Flynsky/VHF_Transceiver/doc/latex/overview.tex

\input{setup.tex}
% install libaries with: sudo dnf install texlive-scheme-medium
% compile with: pdflatex -shell-escape dsp_cheatsheet.tex

\begin{document}
\begin{center}
	{\vspace{-4cm}
		\LARGE \textbf{VHF Tranceiver for CUBSAT Applications}}\\
	\small Fynn Gewiese | \href{https://github.com/Flynsky}{github}\\
	\rule{\linewidth}{0.3pt}
\end{center}

% \begin{multicols*}{2}
\raggedcolumns{\small\tableofcontents}

\section{Requirements}

\begin{minipage}{0.45\textwidth}
	\begin{itemize}
		\item Frequency Band: 134--174\,MHz (VHF)
		\item Data Rate: > 1k bps
		\item Tx Power: 0.3\,W / -5.2 dBW / 25.8 dBm
		\item Antenna Gain Satellite: >= 2.2 dBi
		\item Sattellite Effective Isotropic Radiated Power: -5.3 dBW
		\item Rx Sensitivity:
		\item TCXO Temperature Compensated Crystal Oscillator
	\end{itemize}
\end{minipage}
\hfill
\begin{minipage}{0.5\textwidth}
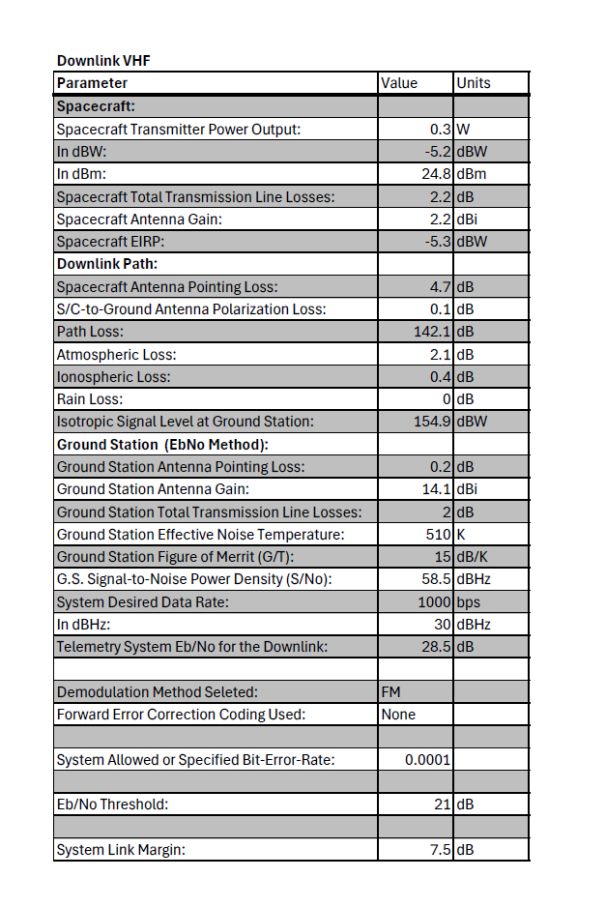
[picture p1: doc/latex/assets/RequireGroundstation.png]
	
	{Random Requirements from Christian}
\end{minipage}

\newpage
Friis Power Estimate:
\begin{figure}[H]
	\centering
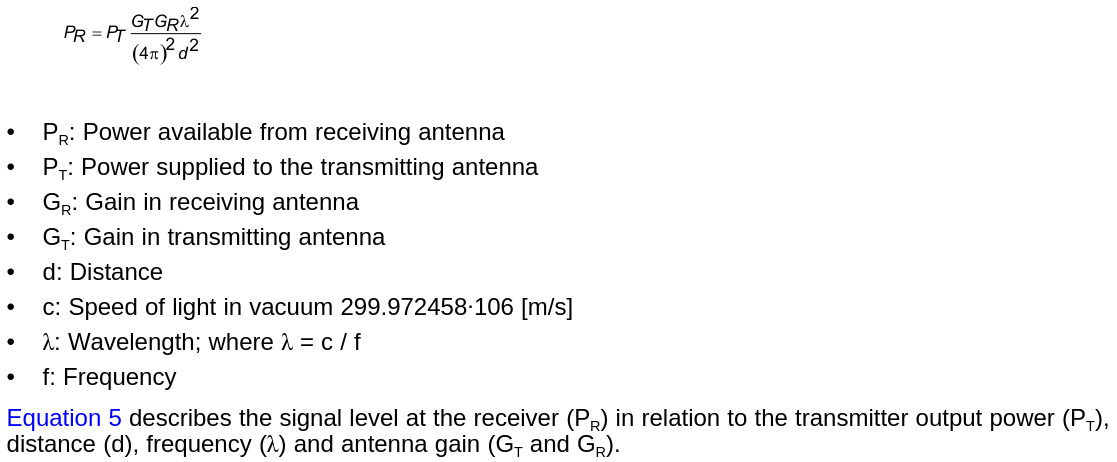
[picture p2: doc/latex/assets/Friis.png]
	
	\caption{}
	\label{fig:friis}
\end{figure}

\newpage
\section{Transceiver}

\subsection{Selection}
Ain't noboady designing a rf frontend from scratch,
an integrated seolution is the way to go.
Modules would be certified and less work,
but don't offer best flexibility and are boring af (for real).

Chips would require design and measurement of the antenna matching circuit,
but also could possibly compensate an antenna missmatch
and are only power limited by how much of an power amplifier you add.
\begin{itemize}
	\item CC1121/5 digital and well documented. Goat
	\item STM32 chips: SPIRIT1QTR, S2-LP, STM32WLE4/5xx well documented, STM in HF is iffy though
	\item ADF7020-1BCPZ-RL7 cheap Analog Devices. surley good (AD always cooking), but not very popular
	\item SA818-U looks like trash because it is. Analog FM. Very popular
	\item SX1261/2 150 MHz - 960 MHz Who tf is Semtech? Good on paper though
	\item Si446x (119–1050 MHz), looks perfect, reddit says: "\href{https://www.reddit.com/r/amateurradio/comments/qtlhz3/rf_tranceiver_ics_any_that_cover_2m_125m_70cm_and/}{most incredibly dense collection of bugs of any part I've ever worked with}".
	\item AX5043 Good things on the internet. N.A and Dead but apperently good
\end{itemize}

\subsection{CC1121/5}
Pin compatible Chips, CC1125 has a more narrow band than CC1121 so is to be preferred.
Can be paired with a power amplifier like Gali 74+ to get +38 dBm :) \href{https://www.youtube.com/watch?v=9ZoO_AABzqU&t=313s}{youtube link}

% \begin{figure}[H]
% 	\begin{minipage}{0.28\textwidth}
% 		\centering
% 		\includegraphics[width=\textwidth]{assets/CC1125.png}
% 		\caption{cc1125}
% 	\end{minipage}
% 	\begin{minipage}{0.28\textwidth}
% 		\centering
% 		\includegraphics[width=\textwidth]{assets/Gali74.png}
% 		\caption{Gali74 +}
% 	\end{minipage}
% \end{figure}

\begin{figure}[H]
	\begin{minipage}{0.20\textwidth}
		\centering
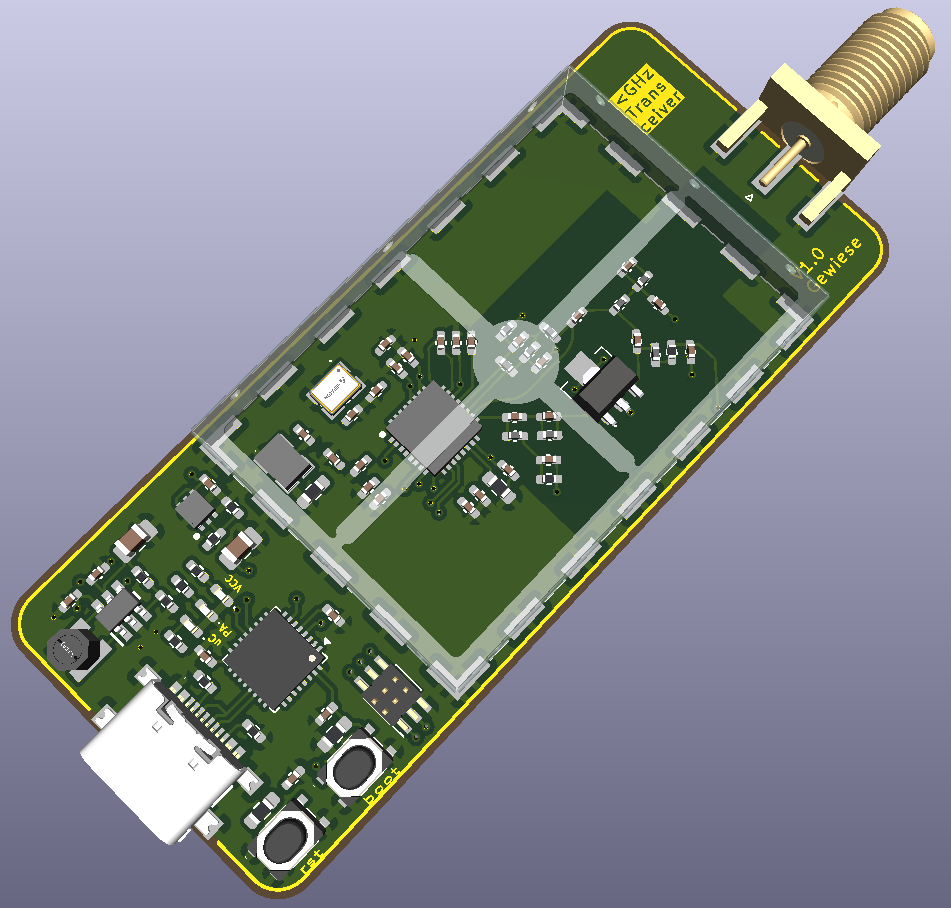
[picture p3: doc/latex/assets/3Drender.png]
		
		\caption{3D render}
	\end{minipage}
	\begin{minipage}{0.70\textwidth}
		\centering
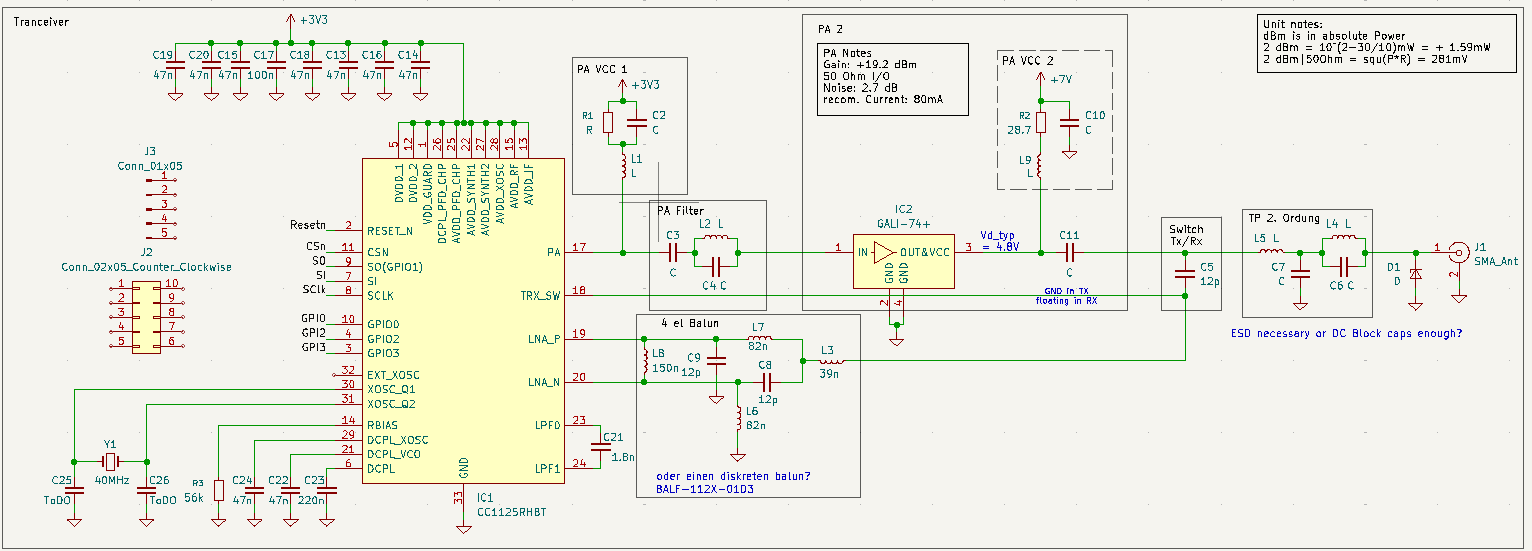
[picture p4: doc/latex/assets/schematic.png]
		
		\caption{schematic}
	\end{minipage}
\end{figure}

\begin{figure}[H]
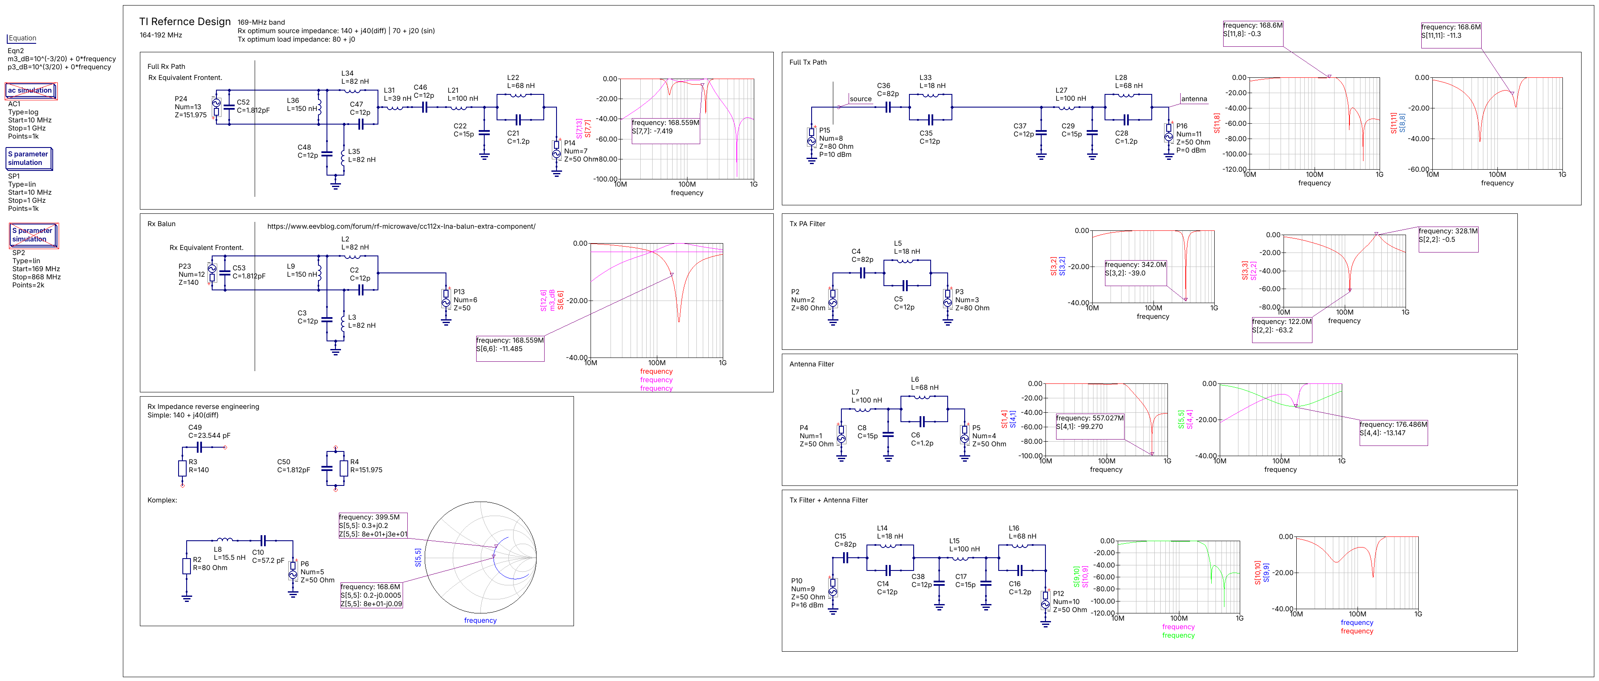
[picture p5: doc/latex/assets/simul.png]
	
\end{figure}
% \begin{figure}[h]
%   \centering
%   \includegraphics[width=0.8\textwidth]{assets/oi.png}
%   \caption{}
%   \label{fig:oi}
% \end{figure}

\subsection{SA818-U}
RDA1846 (8 dBm) chip + PA + microcontroller. \href{http://ptptelecom.com/openlmrorg/Tiny_Transcievers.html}{Disassembly}
\begin{figure}[H]
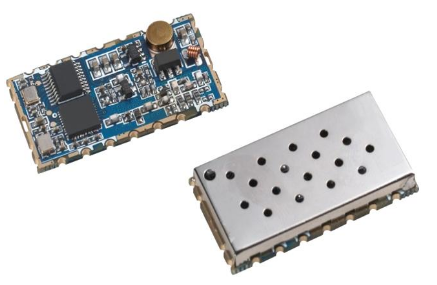
[picture p6: doc/latex/pics/SA818.png]
	
\end{figure}

\newpage
\section{Antenna}

\subsection{Mechanical considerations}
\paragraph{Requirements:}
\begin{itemize}
	\item Non ferro magnetic
	\item good impedance match
\end{itemize}

\paragraph{Antenna Types:}.

\begin{figure}[H]
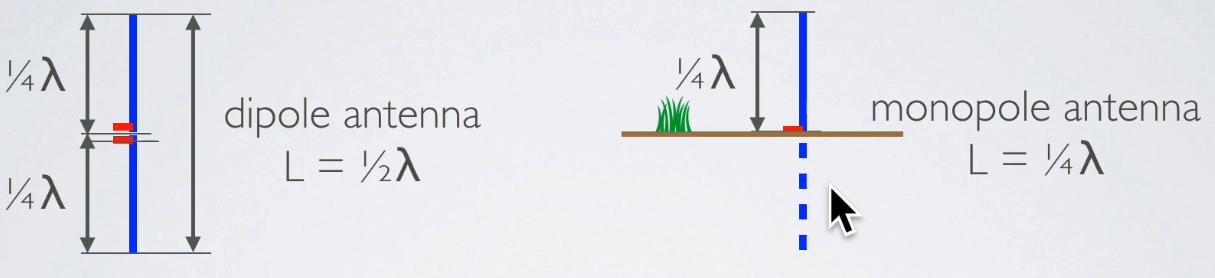
[picture p7: doc/latex/assets/monovsdipole.png]
	
	\caption{Mono vs Dipole}
\end{figure}
\href{https://www.youtube.com/watch?v=doDcpkyw-U8}{good video about antenna design}
\begin{table}[H]
	\centering
	\renewcommand{\arraystretch}{1.3}
	\begin{tabular}{llllll}
		\toprule
		\textbf{} & \textbf{Antenna Type}  & \textbf{Length} (150MHz) & \textbf{Impedance ($\Omega$)} & \textbf{Gain (dBi)} & \textbf{Notes}                         \\
		\midrule
		\multicolumn{6}{l}{\textit{Dipole Variants}}                                                                                                     \\
		\midrule
		\textcolor{red}{N}  & $3\lambda/2$ Dipole    & $1.5\lambda = 3.0\,$m    & $\approx 100$--$150$          & $3.8$               & Narrower pattern                       \\
		\textcolor{red}{N}  & Full-Wave Dipole       & $\lambda = 2.0\,$m       & $\approx 200$                 & $2.41$              & High impedance                         \\
		\textcolor{green}{Y} & Half-Wave Dipole       & $\lambda/2 = 1.0\,$m     & $\approx 73$                  & $2.15$              & Reference antenna                      \\
		\textcolor{yellow}{M}  & Folded Dipole          & $\lambda/2 = 1.0\,$m     & $\approx 288$                 & $2.15$              & Wider bandwidth                        \\
		\textcolor{yellow}{M} & Short Dipole           & $\ll \lambda/2$          & $\approx 20 + jX$             & $< 2.15$            & Needs matching, very small             \\
		\midrule
		\multicolumn{6}{l}{\textit{Monopole Variants (over ground plane)}}                                                                               \\
		\midrule
		\textcolor{red}{N}  & Half-Wave Monopole     & $\lambda/2 = 1.0\,$m     & $\approx 100$--$150$          & $5.2$               & High impedance                         \\
		\textcolor{green}{Y}  & Quarter-Wave Monopole  & $\lambda/4 = 0.5\,$m     & $\approx 36.5$                & $5.15$              & Most common, easy to match             \\
		\textcolor{green}{Y}  & Five-Eighths Monopole  & $5\lambda/8 = 1.25\,$m   & $\approx 50$                  & $6.0$               & Self-matching, popular \href{https://www.pmr-funkgeraete.de/Funkgeraete/Amateurfunk/Zubehoer-AFU/Mobilantennen-AFU-KW-VHF-UHF/Diamond-MC-101-PL-Antennenstrahler-134-174-MHz::11365.html}{commercial example}                \\
		\textcolor{yellow}{M}  & Three-Eighths Monopole & $3\lambda/8 = 0.75\,$m   & $\approx 150 + j150$          & $5.5$               & Needs matching                         \\
		\textcolor{red}{N}  & Short Monopole         & $\ll \lambda/4$          & $\approx 10 + jX$             & $< 5.15$            & Needs matching                         \\
		\midrule
		\multicolumn{6}{l}{\textit{CubeSat-Relevant Antennas at 150\,MHz ($\lambda \approx 2.0\,$m)}}                                                    \\
		\midrule
		\textcolor{yellow}{Y}  & Turnstile              & $2\times\lambda/2$       & $\approx 50$                  & $2.15$              & Circular polarization, low profile     \\
		\textcolor{yellow}{Y}  & Crossed Dipole         & $2\times\lambda/2$       & $\approx 73$                  & $2.15$              & Circular pol., needs 90° hybrid        \\
		\textcolor{green}{Y}  & Tape Measure Dipole    & $\lambda/2 = 1.0\,$m     & $\approx 73$                  & $2.15$              & Deployable, flight-proven              \\
		\textcolor{green}{Y}  & \href{https://www.youtube.com/watch?v=bElqBRvqTdo}{Stacer Monopole}       & $\lambda/4 = 0.5\,$m     & $\approx 36.5$                & $5.15$              & Deployable coil spring, common CubeSat \\
		\textcolor{yellow}{M}  & Patch (on body)        & $\lambda/2$ aperture     & $\approx 100$--$300$          & $6.0$--$8.0$        & Low profile, but large at 150\,MHz     \\
		\textcolor{yellow}{M}  & Helical (axial mode)   & $n \cdot \lambda$        & $\approx 100$--$150$          & $10$--$15$          & Circular pol., high gain, directional  \\
		\bottomrule
	\end{tabular}
	\caption{Dipole, monopole, and CubeSat antenna options at $150\,\text{MHz}$ ($\lambda \approx 2.0\,\text{m}$, $\lambda/2 \approx 1.0\,\text{m}$, $\lambda/4 \approx 0.5\,\text{m}$)}
	\label{tab:antenna_150MHz}
\end{table}
So dipole is huge,
but monopole is also problematic.
It needs a ground plane, which can be solid or wires or a mesh.
If the groundplane radius is higher than $1/2 \lambda$ it's aproximately infinite 
and performance is optimal.
Groundplain changes gain and impedance.

\begin{figure}[H]
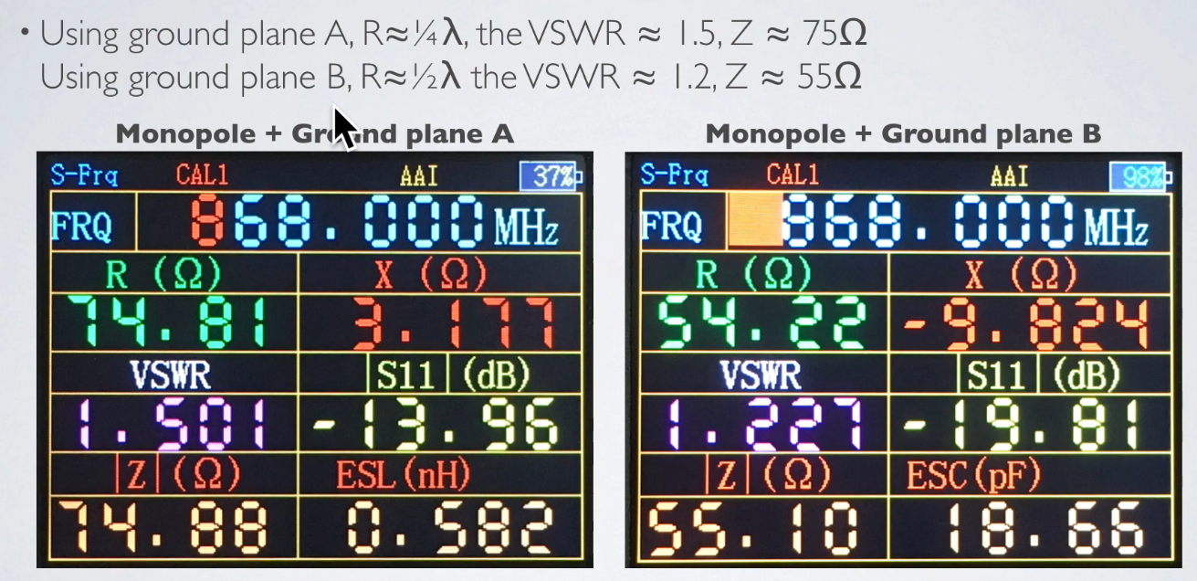
[picture p8: doc/latex/assets/ground plane effect out of a randoms youtubers video.png]
  
  \caption{ground plane effect out of a randoms youtubers video}
\end{figure}

The sides of the cubesat are an start, but 10x10cm are way smaller than the required $1/2 \lambda$.\\
Maybe the solar panels could function as ground plane?

\paragraph{Ti Research of 196 MHz Antennas}.

\begin{figure}[H]
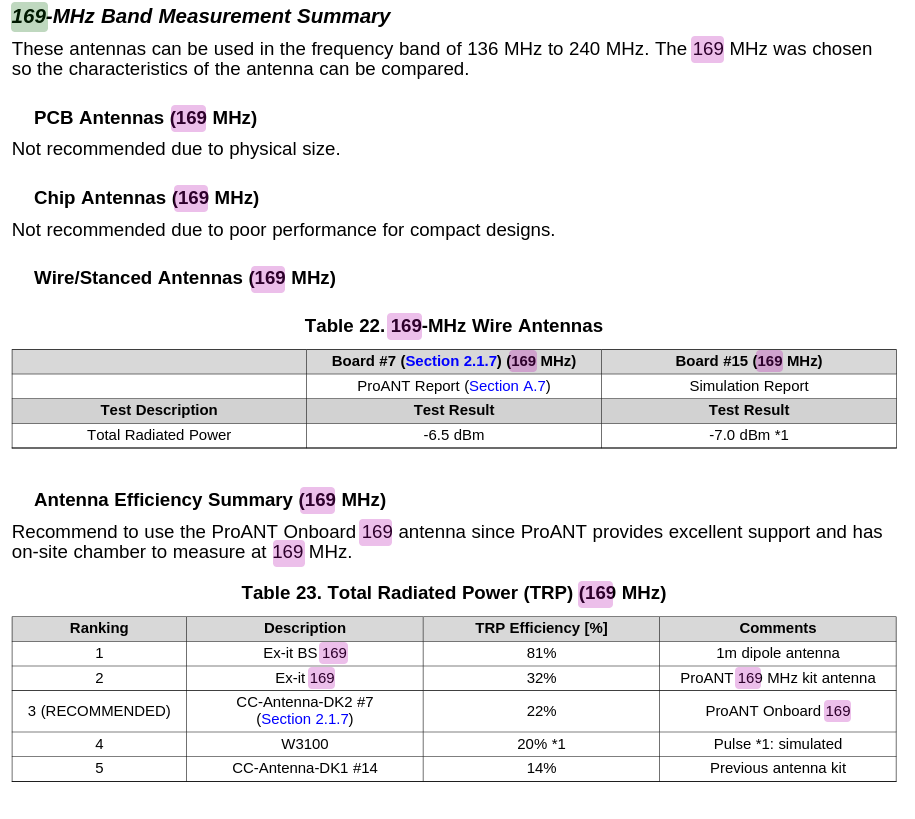
[picture p9: doc/latex/assets/TiAntennaComparison.png]
	
	\caption{Ti application note swra496a page 45 antenna comparison}
	\label{fig:tiantennacomparison}
\end{figure}

\paragraph{Spring based system:}.

\begin{figure}[H]
	\begin{minipage}{0.38\textwidth}
		\centering
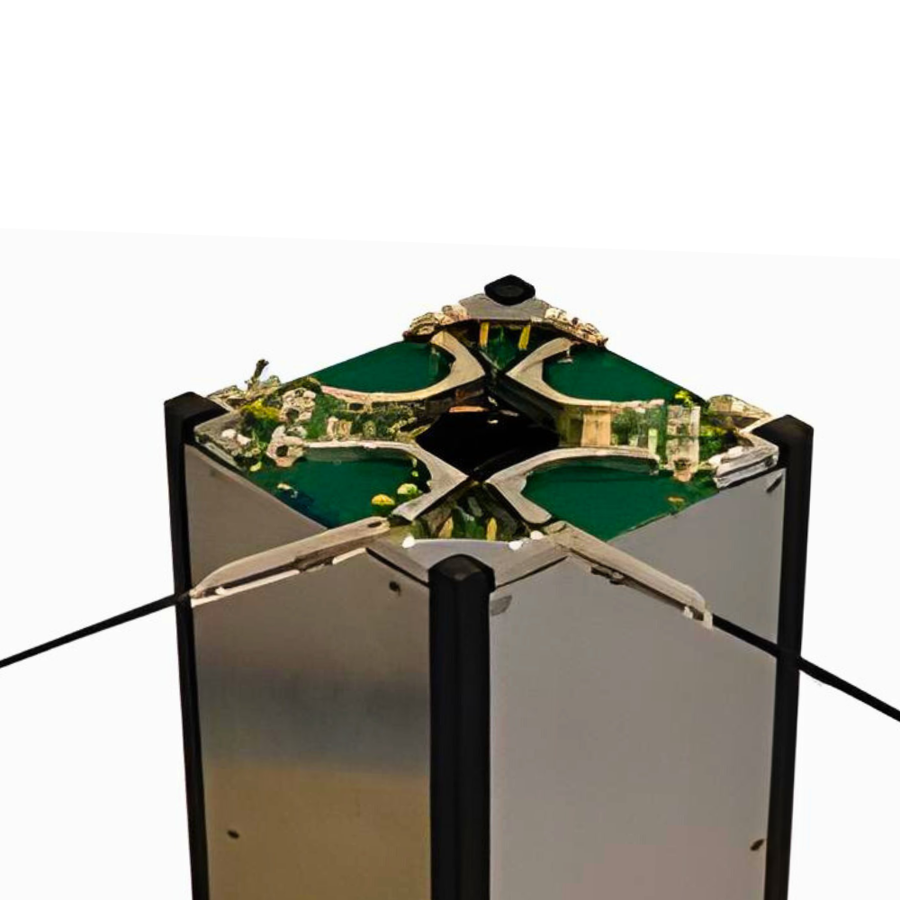
[picture p10: doc/latex/assets/commertialSolution.png]
		
		\caption{Commertial solution \href{https://www.isispace.nl/product/vhf-uhf-antenna-for-1u-3u/}{ISISPACE VHF/UHF antenna}}
		\label{fig:commertialsolution}
	\end{minipage}
	\begin{minipage}{0.38\textwidth}
		\centering
		
	\end{minipage}
\end{figure}

\paragraph{Roll based system:}.
\begin{figure}[H]
	\begin{minipage}{0.38\textwidth}
		\centering
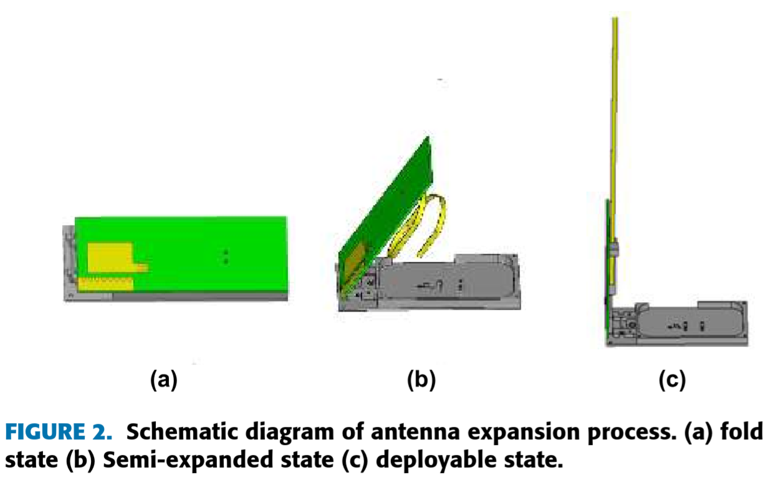
[picture p12: doc/latex/pics/fold.png]
		
		\caption{\href{https://www.researchgate.net/publication/342999505_Compact_UHFVHF_Monopole_Antennas_for_CubeSats_Applications}{paper}}
		% \label{fig:cc1125}
	\end{minipage}
	\begin{minipage}{0.38\textwidth}
		\centering
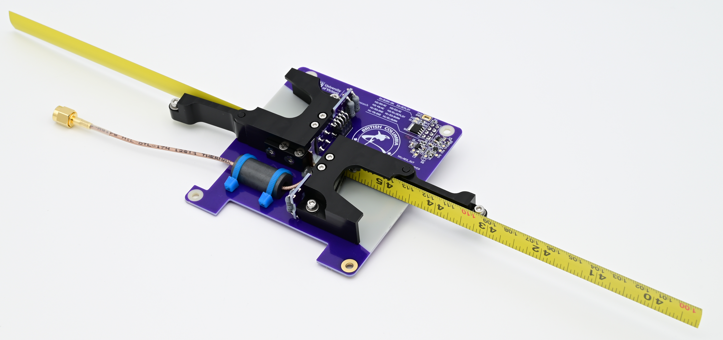
[picture p13: doc/latex/pics/spring.jpg]
		
		\caption{\href{https://gitlab.orcasat.ca/orcasat-group/orcasat-antenna}{OrcaSat}}
		\label{fig:gali74}
	\end{minipage}
\end{figure}

\paragraph{SMD Antenna:}.

\begin{figure}[H]
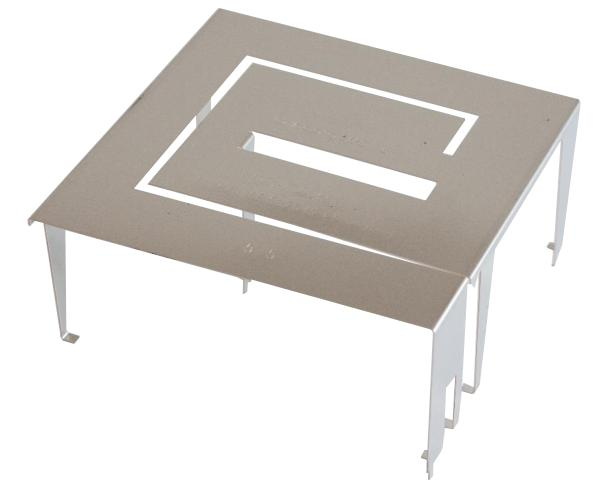
[picture p14: doc/latex/assets/smdantenna.png]
	
	\caption{\href{https://satronel.com/products/antennas/embedded/proant-pifa-antennas/onboard-smd-169-mhz-pro-ob-508.html}{OnBoard PRO-OB-508}}
\end{figure}

\subsection{Material Choice}
The non ferromagnetic requirement will need an exotic metal
and probably a treatment like hardening or cold rolling.
\begin{itemize}
	\item strip steel. Used in tape measures. ferromagnetic but serves as comparison.
	\item Beryllium copper (C17200). Very sex(according to google AI). no way that this springs. on amazon. \href{https://www.youtube.com/shorts/Kf07CvRD3Ck}{youtube link}
	\item 13RM19. strip steel but special non ferromagnetic. hard to obtain, ask for offcuts?
	\item 1.4310. shitty brother of 13RM19
\end{itemize}

\begin{tabular}{lcccc}
	\toprule
	\textbf{material} & magnetization & Dehngrenze $R_{p0{,}2\%}$ & elastisity  & specific R \\
	                  &               & $N/mm ^ 2$                & $kN/mm ^ 2$              \\
	\midrule
	1.4310            & low           & 210                       & 200                      \\
	                  &               &                           &                          \\
	                  &               &                           &                          \\
	\bottomrule
\end{tabular}

\begin{figure}[h]
  \centering
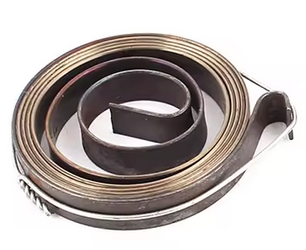
[picture p15: doc/latex/assets/copper_measer.png]
  
  \caption{\href{https://www.alibaba.com/product-detail/HengSheng-Beryllium-Copper-Flat-Tape-Measure_1600205576417.html}{rewind spring for leaf blower Beryllium Copper Flat Tape}}
  \label{fig:copper_measer}
\end{figure}
\subsection{Simulation}
free to use software:
\begin{itemize}
	\item 4nec2
	\item MMANA-GAL
\end{itemize}

\subsection{Testing}

\subsection{Relevant papers:}
\begin{itemize}
	\item \href{}{Compact UHF/VHF Monopole Antennas for CubeSats Applications}
\end{itemize}

% \end{multicols*}
\end{document}
