Flynsky/VHF_Transceiver/doc/latex/overview.pdf

## VHF Tranceiver for CUBSAT Applications

Fynn Gewiese | github (https://github.com/Flynsky)

## Inhaltsverzeichnis

1 Requirements | 1
2 Transceiver | 3
3 Antenna | 4

## 1 Requirements

- Frequency Band: 134–174 MHz (VHF)
- Data Rate: > 1k bps
- Tx Power: 0.3W / -5.2 dBW / 25.8 dBm
- Antenna Gain Satellite: >= 2.2 dBi
- Sattellite Effective Isotropic Radiated Power: -5.3 dBW
- Rx Sensitivity:
- TCXO Temperature Compensated Crystal Oscillator

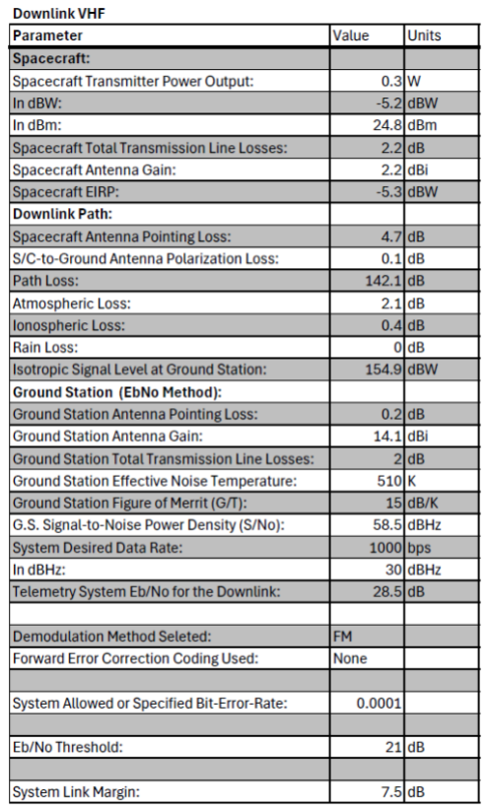
[picture p16: figure]

Random Requirements from Christian

Friis Power Estimate:


Abbildung 1

## 2 Transceiver

### 2.1 Selection

There are not many transcievers chips avaliable. Chips would require design and measurement of the antenna matching circuit, but also could possibly compensate an antenna missmatch.

- CC1121/5 digital and well documented. Requires PA like SMA70-2
- ADF7020-1BCPZ-RL7 cheap Analog Devices.
- SA818-U looks like trash because it is. Analog FM
- SX1261/2 150 MHz - 960 MHz
- Si446x (119–1050 MHz), looks perfect, reddit says is a bit buggy.
- AX5043 Good things on the internet. N.A and Dead but apperently good

### 2.2 CC1121/5

Pin compatible Chips, CC1125 has a more narrow band than CC1121 so is to be preferred. Can be paired with a power amplifier like Gali 74+ to get +38 dBm :) youtube link (https://www.youtube.com/watch?v=9ZoO_AABzqU&t=313s)

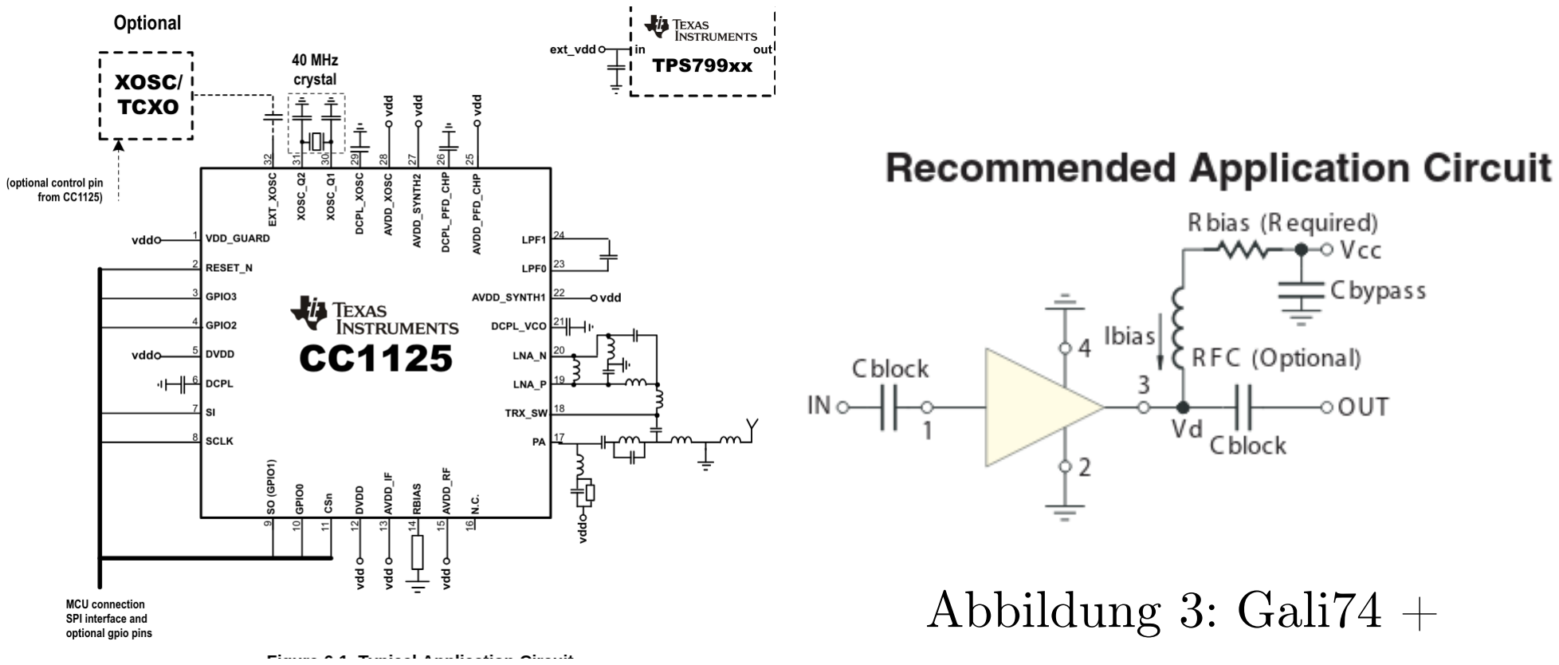
[picture p17: figure]
Abbildung 3: Gali74 +

Abbildung 2: cc1125

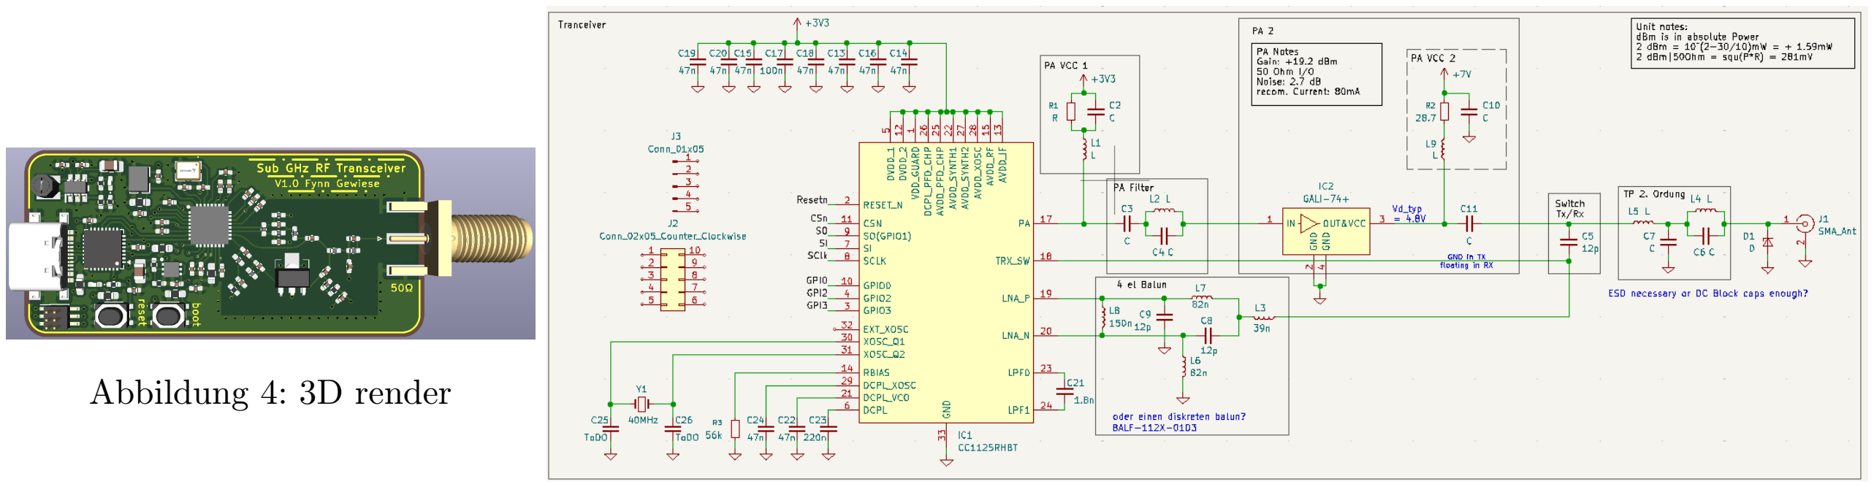
[picture p18: figure]
Abbildung 4: 3D render

Abbildung 5: schematic


### 2.3 SA818-U

RDA1846 (8 dBm) chip + PA + microcontroller. Disassembly (http://ptptelecom.com/openlmrorg/Tiny_Transcievers.html)

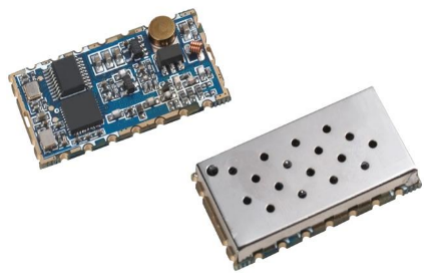
[picture p19: figure]

### 2.4 Si446x

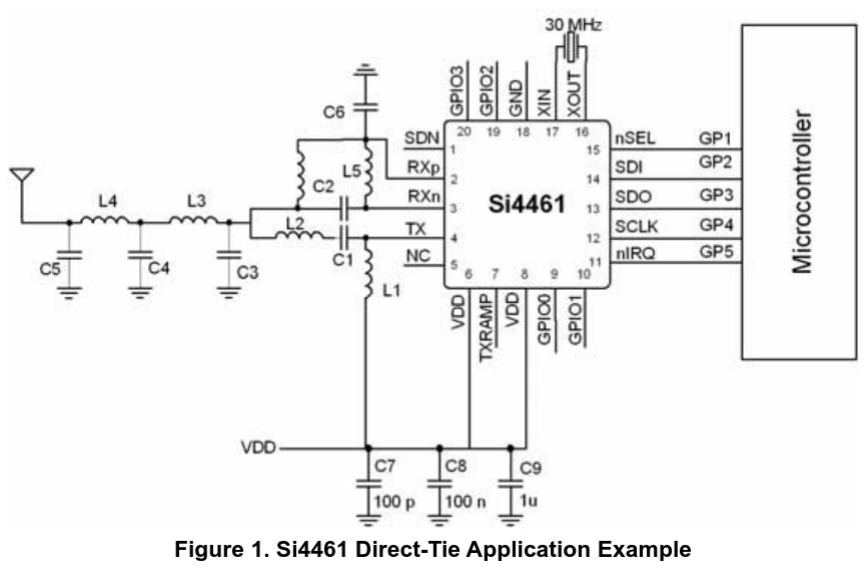
[picture p20: figure]

## 3 Antenna

### 3.1 Mechanical considerations

Requirements:

- Non ferro magnetic
- good impedance match

Length estimate: .

Often used for monopoles are λ/4:

lmonopole =

λ
4

=

c
4f

=

300
4f [MHz]

=

75
f [MHz]

m = 0.5 m at 150 MHz

Also commonly commercial used antennas are 5/8λ lengths. That is around 125 cm comertial example. (https://www.pmr-funkgeraete.de/Funkgeraete/Amateurfunk/Zubehoer-AFU/Mobilantennen-AFU-KW-VHF-UHF/Diamond-MC-101-PL-Antennenstrahler-134-174-MHz::11365.html)

Ti Research of 196 MHz Antennas .


Abbildung 6: Ti application note swra496a page 45 antenna comparison

Spring based system: .


Abbildung 7: Commertial solution ISISPACE VHF/UHF antenna (https://www.isispace.nl/product/vhf-uhf-antenna-for-1u-3u/)

Roll based system: .

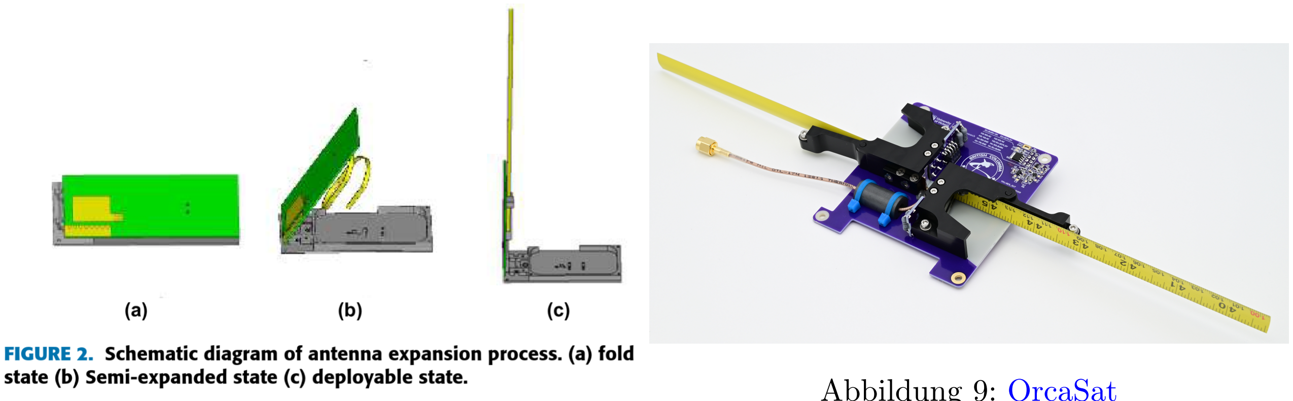
[picture p21: figure]

Abbildung 8: paper (https://www.researchgate.net/publication/342999505_Compact_UHFVHF_Monopole_Antennas_for_CubeSats_Applications)


Abbildung 9: OrcaSat (https://gitlab.orcasat.ca/orcasat-group/orcasat-antenna)

SMD Antenna: .

Abbildung 10: OnBoard PRO-OB-508 (https://satronel.com/products/antennas/embedded/proant-pifa-antennas/onboard-smd-169-mhz-pro-ob-508.html)


### 3.2 Material Choice

The non ferromagnetic requirement will need an exotic metal and probably a treatment like hardening or cold rolling.

- strip steel. Used in tape measures. ferromagnetic but serves as comparison.
- Beryllium copper (C17200). Very sex(according to google AI). no way that this springs. on amazon. youtube link (https://www.youtube.com/shorts/Kf07CvRD3Ck)
- 13RM19. strip steel but special non ferromagnetic. hard to obtain, ask for offcuts?
- 1.4310. shitty brother of 13RM19
material | magnetization | Dehngrenze Rp0,2% | elastisity | specific R
| | N/mm² | kN/mm²
1.4310 | low | 210 | 200

### 3.3 Simulation 3.4 Testing 3.5 Relevant papers:

- Compact UHF/VHF Monopole Antennas for CubeSats Applications
