Flynsky/VHF_Transceiver/doc/latex/assets/3D render.png

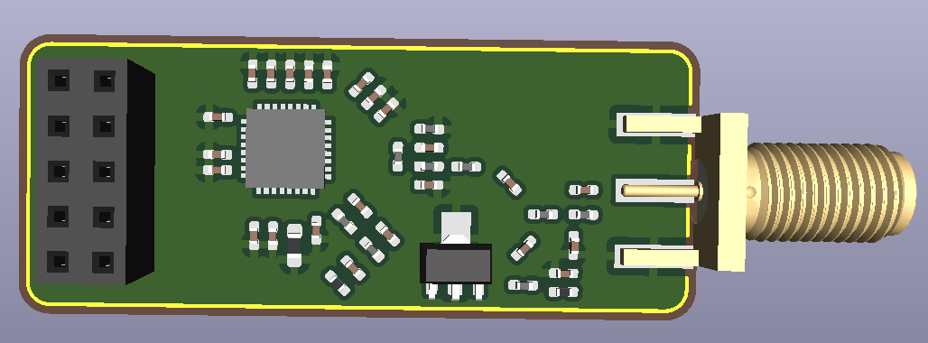
doc/latex/assets/3D render.png
