Flynsky/VHF_Transceiver/doc/latex/assets/CC1125.png

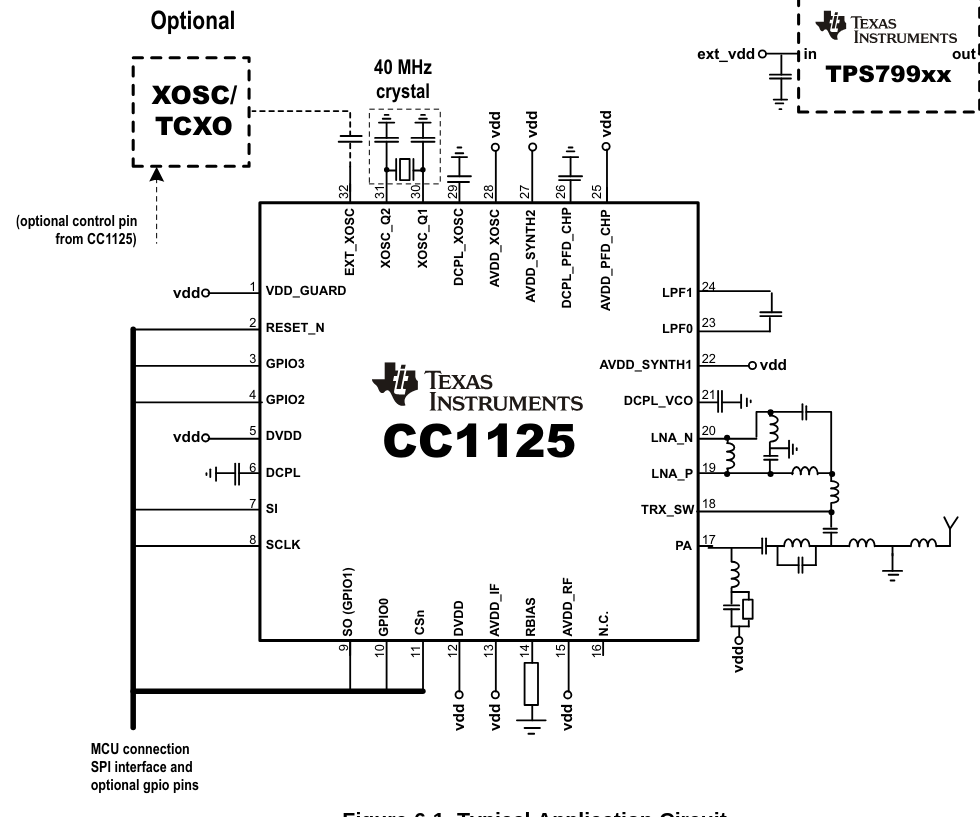
doc/latex/assets/CC1125.png
