Flynsky/VHF_Transceiver/doc/latex/assets/cooked.png

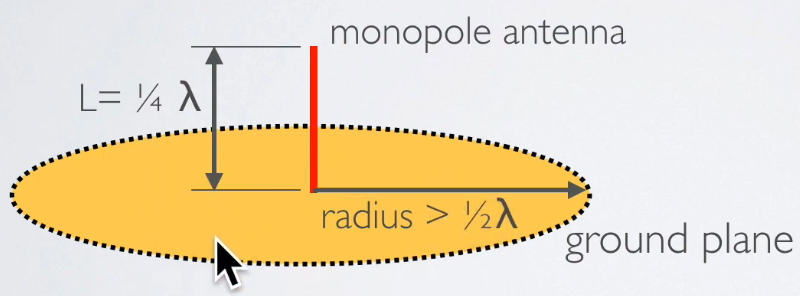
doc/latex/assets/cooked.png
