Flynsky/VHF_Transceiver/doc/latex/assets/Gali74.png

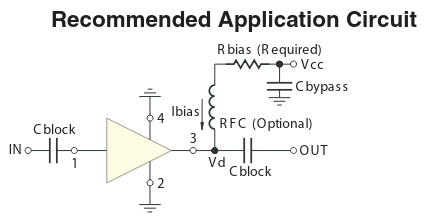
doc/latex/assets/Gali74.png
