Flynsky/VHF_Transceiver/doc/latex/assets/oi.png

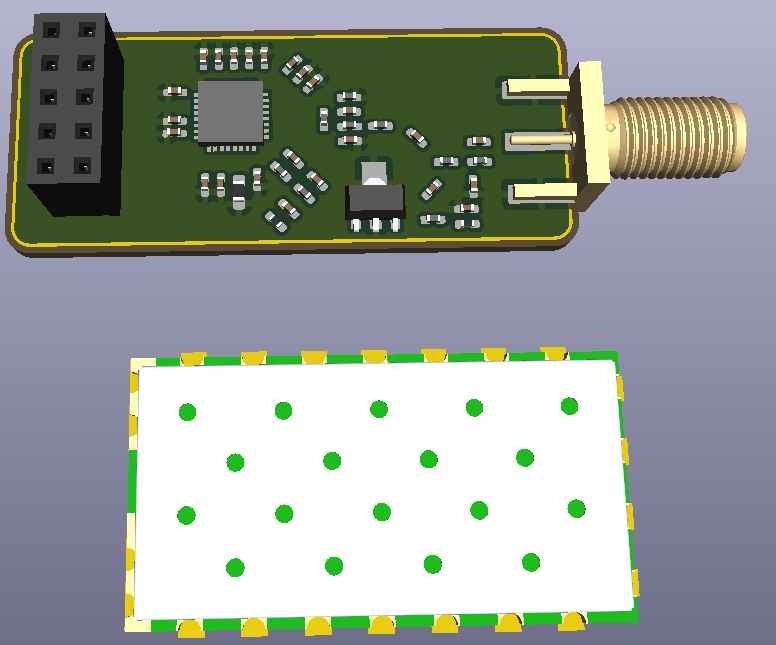
doc/latex/assets/oi.png
