Flynsky/VHF_Transceiver/doc/latex/assets/si.png

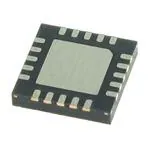
doc/latex/assets/si.png
