Flynsky/VHF_Transceiver/doc/latex/pics/cc1101.png

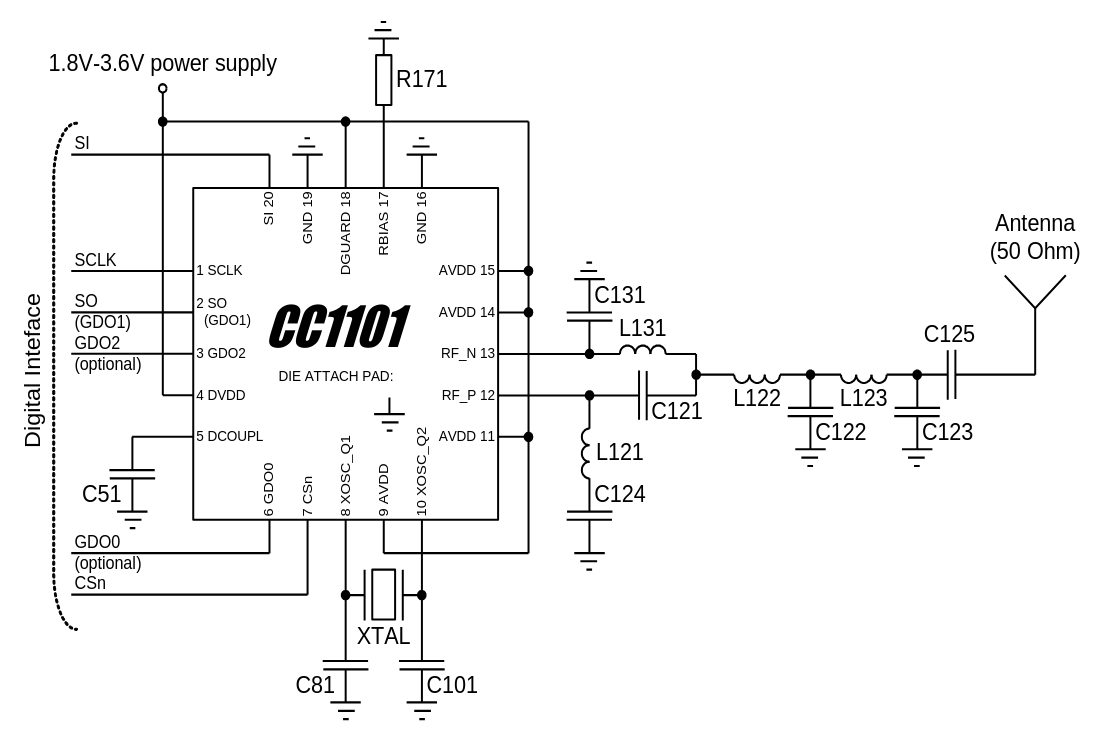
doc/latex/pics/cc1101.png
