Flynsky/VHF_Transceiver/doc/latex/pics/si.png

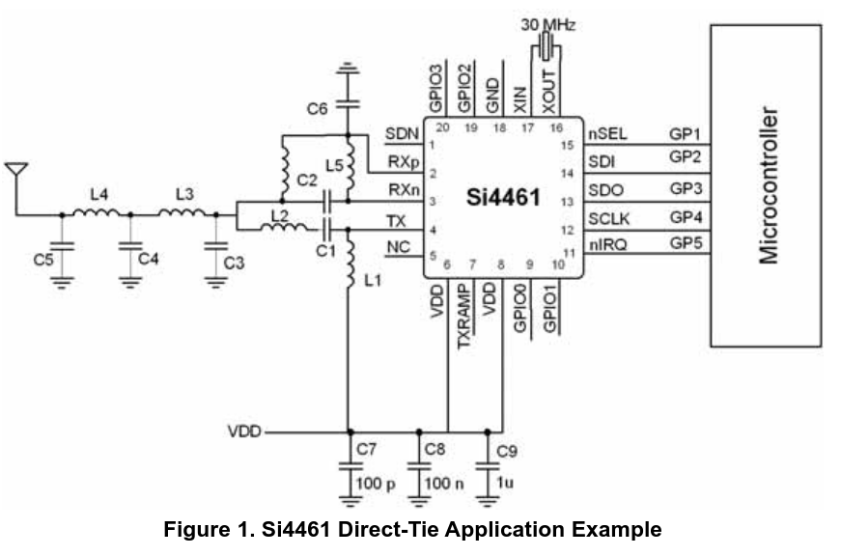
doc/latex/pics/si.png
