Flynsky/VHF_Transceiver/hardware/CC1125_Transceiver/libary/misc/3D/USB4216-03-A.stp

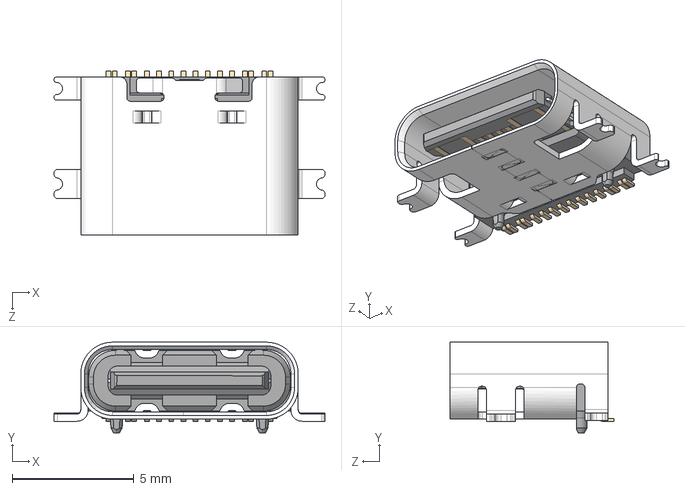
[picture p30: CAD file, 2026-04-06]
hardware/CC1125_Transceiver/libary/misc/3D/USB4216-03-A.stp
11.1 x 3.73 x 6.75 mm
USB4216 Shell
USB4216 Housing&Terminal
