Flynsky/VHF_Transceiver/hardware/CC1125_Transceiver/libary/misc/3D/ABM8W-40.0000MHZ-4-B1U-T3.stp

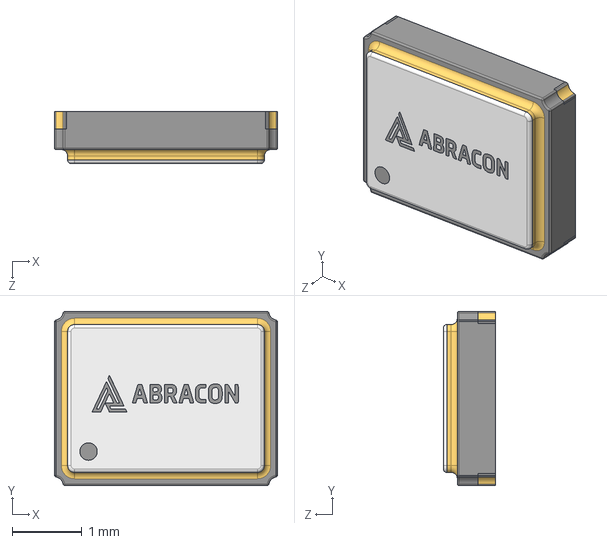
[picture p31: CAD file, 2026-04-06]
hardware/CC1125_Transceiver/libary/misc/3D/ABM8W-40.0000MHZ-4-B1U-T3.stp
3.20 x 2.50 x 0.751 mm
ABM8W-24.0000MHZ-4-D1X-T3
Abracon New Logo
