Flynsky/VHF_Transceiver/hardware/CC1125_Transceiver/libary/misc/3D/ECS-TXO-32CSMV-400-BN-TR.stp

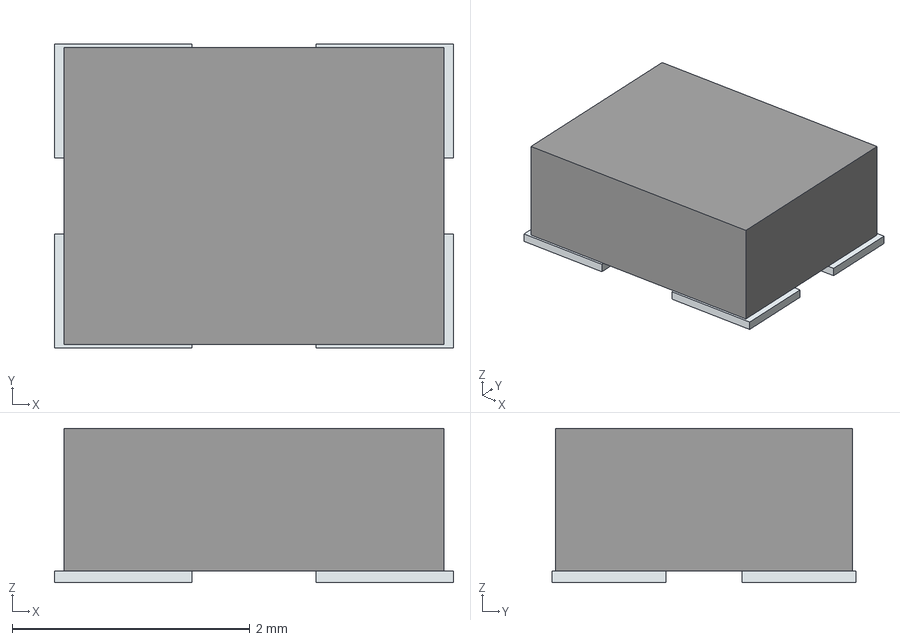
[picture p32: CAD file, 2026-04-06]
hardware/CC1125_Transceiver/libary/misc/3D/ECS-TXO-32CSMV-400-BN-TR.stp
3.36 x 2.56 x 1.30 mm
Pins
