Flynsky/VHF_Transceiver/hardware/CC1125_Transceiver/libary/misc/3D/DRA818V.step

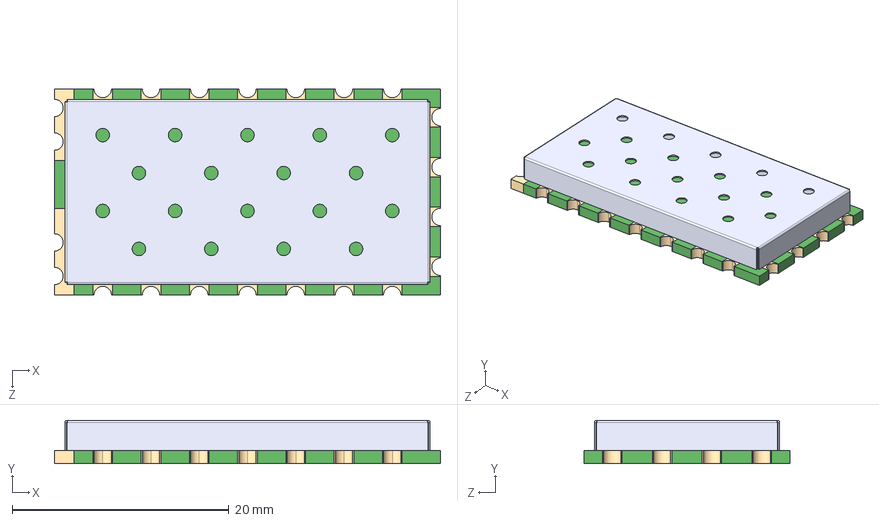
[picture p33: CAD file, 2026-04-03]
hardware/CC1125_Transceiver/libary/misc/3D/DRA818V.step
35.6 x 4.00 x 19.0 mm
