Flynsky/VHF_Transceiver/hardware/CC1125_Transceiver/libary/misc/3D/RFSW6222TR7.stp

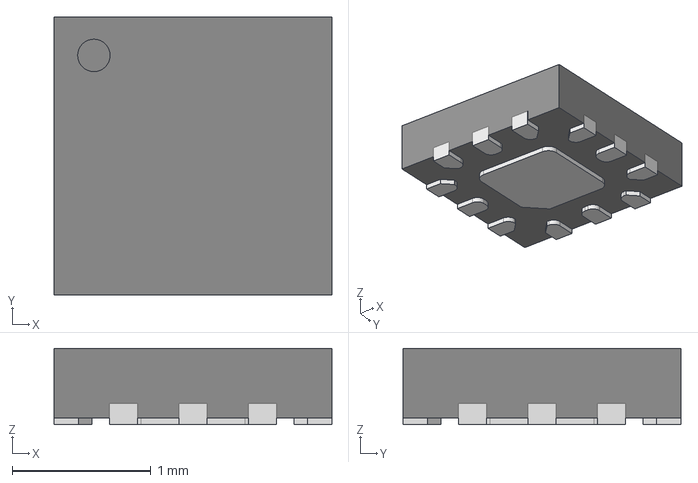
[picture p34: CAD file, 2026-04-02]
hardware/CC1125_Transceiver/libary/misc/3D/RFSW6222TR7.stp
2.00 x 2.00 x 0.55 mm
