Flynsky/VHF_Transceiver/hardware/CC1125_Transceiver/libary/misc/3D/CC1125RHBT.stp

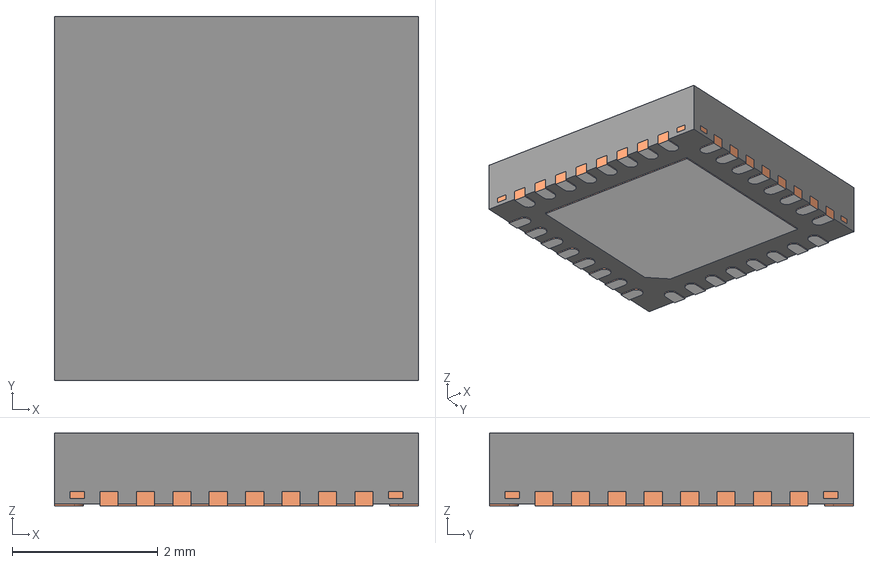
[picture p35: CAD file, 2026-04-02]
hardware/CC1125_Transceiver/libary/misc/3D/CC1125RHBT.stp
5.00 x 5.00 x 1.00 mm
BODY-QFN
FRAME-RHB0032E
PIN1-ID
