Flynsky/VHF_Transceiver/hardware/CC1125_Transceiver/libary/misc/3D/GALI-74+.stp

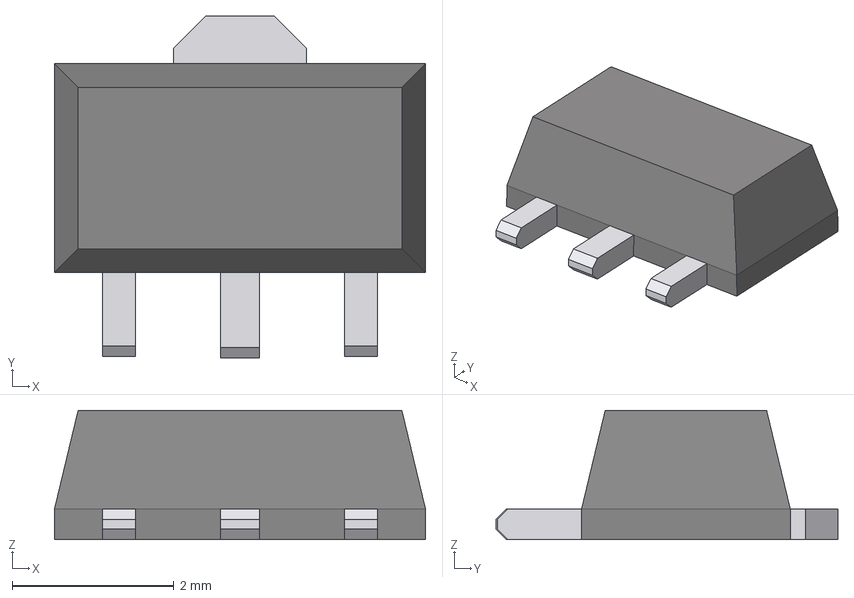
[picture p36: CAD file, 2026-04-02]
hardware/CC1125_Transceiver/libary/misc/3D/GALI-74+.stp
4.60 x 4.23 x 1.60 mm
