Flynsky/VHF_Transceiver/hardware/CC1125_Transceiver/libary/misc/3D/TPS61046YFFR.stp

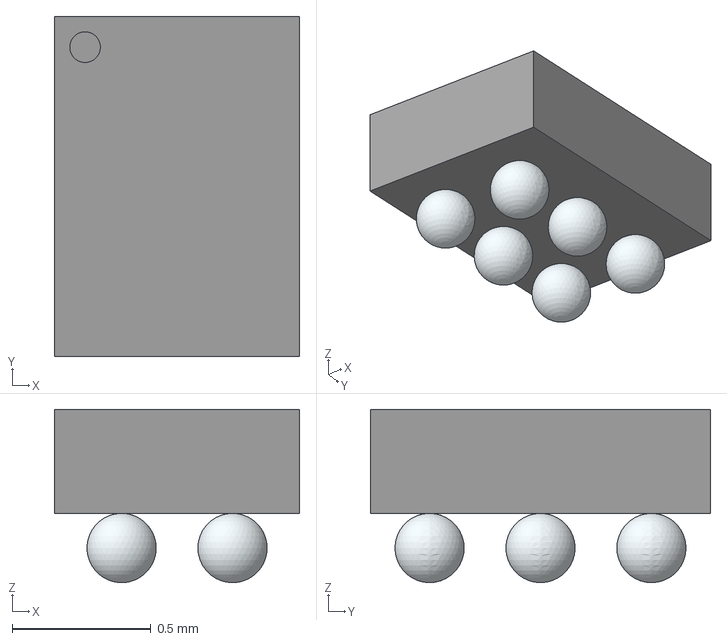
[picture p37: CAD file, 2026-04-06]
hardware/CC1125_Transceiver/libary/misc/3D/TPS61046YFFR.stp
0.884 x 1.23 x 0.625 mm
