Flynsky/VHF_Transceiver/hardware/CC1125_Transceiver/libary/misc/3D/TLV75801PDRVR.stp

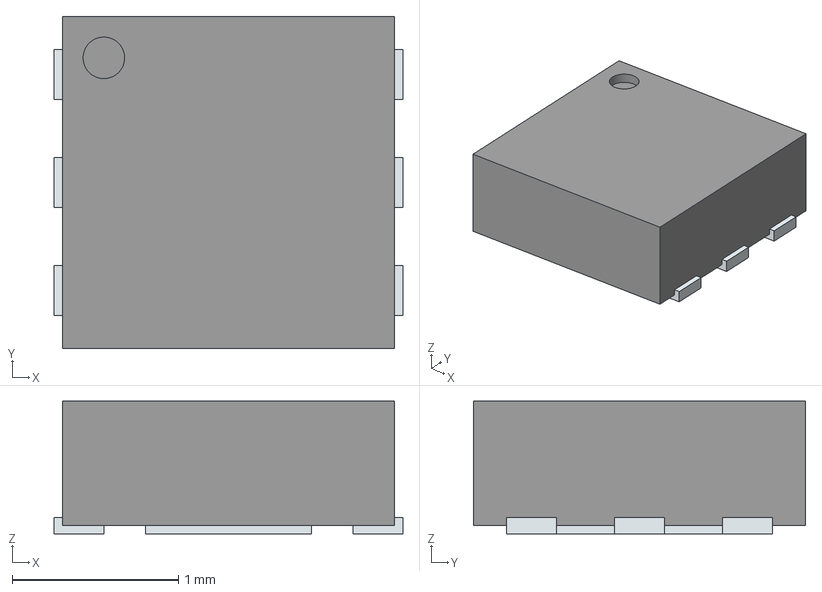
[picture p38: CAD file, 2026-04-06]
hardware/CC1125_Transceiver/libary/misc/3D/TLV75801PDRVR.stp
2.10 x 2.00 x 0.8 mm
ThermalPin
PinsArrayLR
