Flynsky/VHF_Transceiver/hardware/CC1125_Transceiver/libary/misc/3D/TLV61046ADBVT.stp

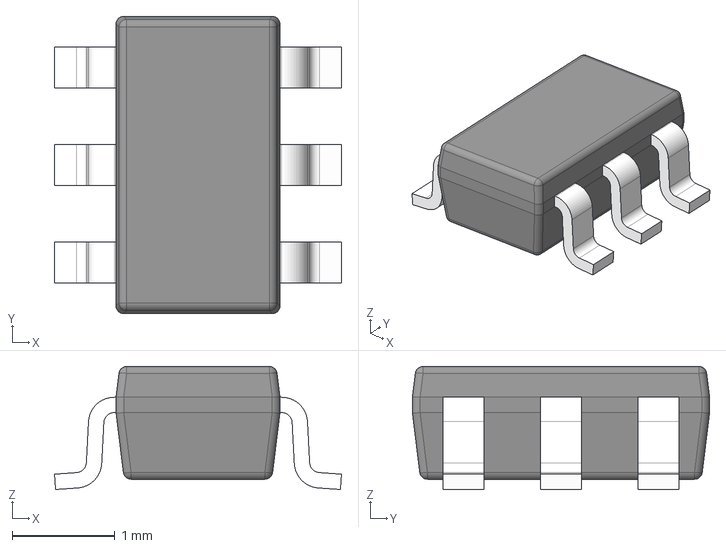
[picture p39: CAD file, 2026-04-06]
hardware/CC1125_Transceiver/libary/misc/3D/TLV61046ADBVT.stp
2.80 x 2.90 x 1.20 mm
BODY-SOT
LEAD-SOT x 6
