Flynsky/VHF_Transceiver/hardware/CC1125_Transceiver/libary/misc/3D/434133025816.stp

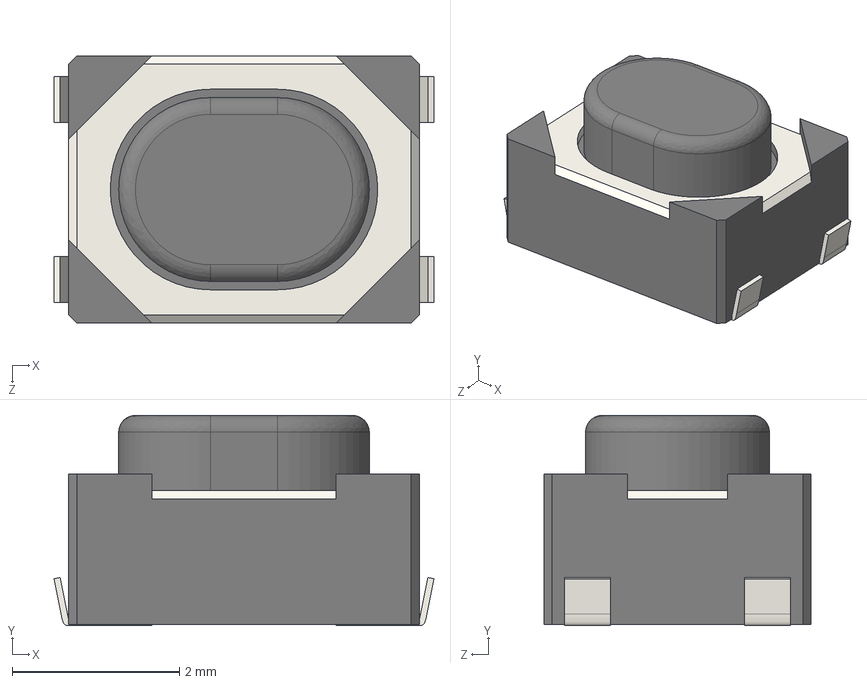
[picture p40: CAD file, 2026-04-06]
hardware/CC1125_Transceiver/libary/misc/3D/434133025816.stp
4.55 x 2.52 x 3.20 mm
