Flynsky/VHF_Transceiver/hardware/CC1125_Transceiver/libary/misc/3D/TPS61071DDCR.stp

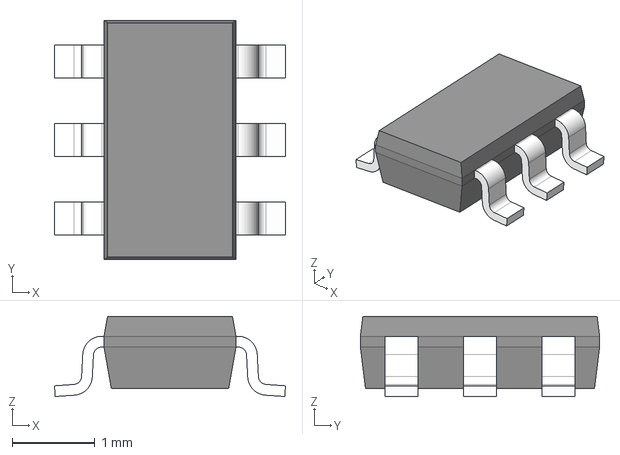
[picture p41: CAD file, 2026-04-06]
hardware/CC1125_Transceiver/libary/misc/3D/TPS61071DDCR.stp
2.80 x 2.90 x 0.97 mm
BODY-SOT
LEAD-SOT x 6
