Flynsky/VHF_Transceiver/hardware/CC1125_Transceiver/libary/misc/3D/744025100.stp

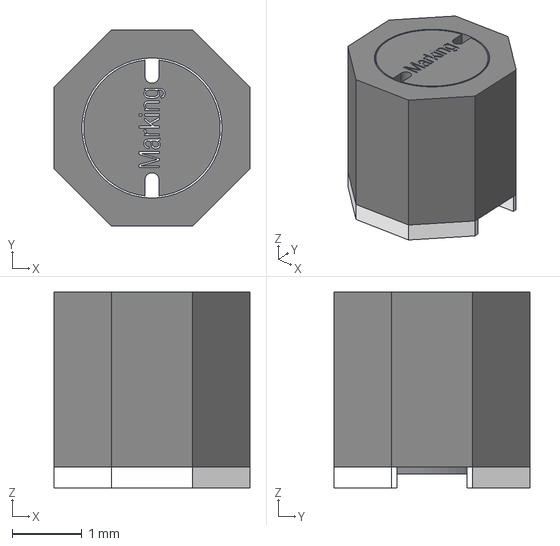
[picture p42: CAD file, 2026-04-06]
hardware/CC1125_Transceiver/libary/misc/3D/744025100.stp
2.80 x 2.80 x 2.80 mm
