Flynsky/VHF_Transceiver/hardware/CC1125_Transceiver/CC1125_Transceiver.kicad_pcb

## KiCad design hardware/CC1125_Transceiver/CC1125_Transceiver.kicad_pcb (2026-04-08)

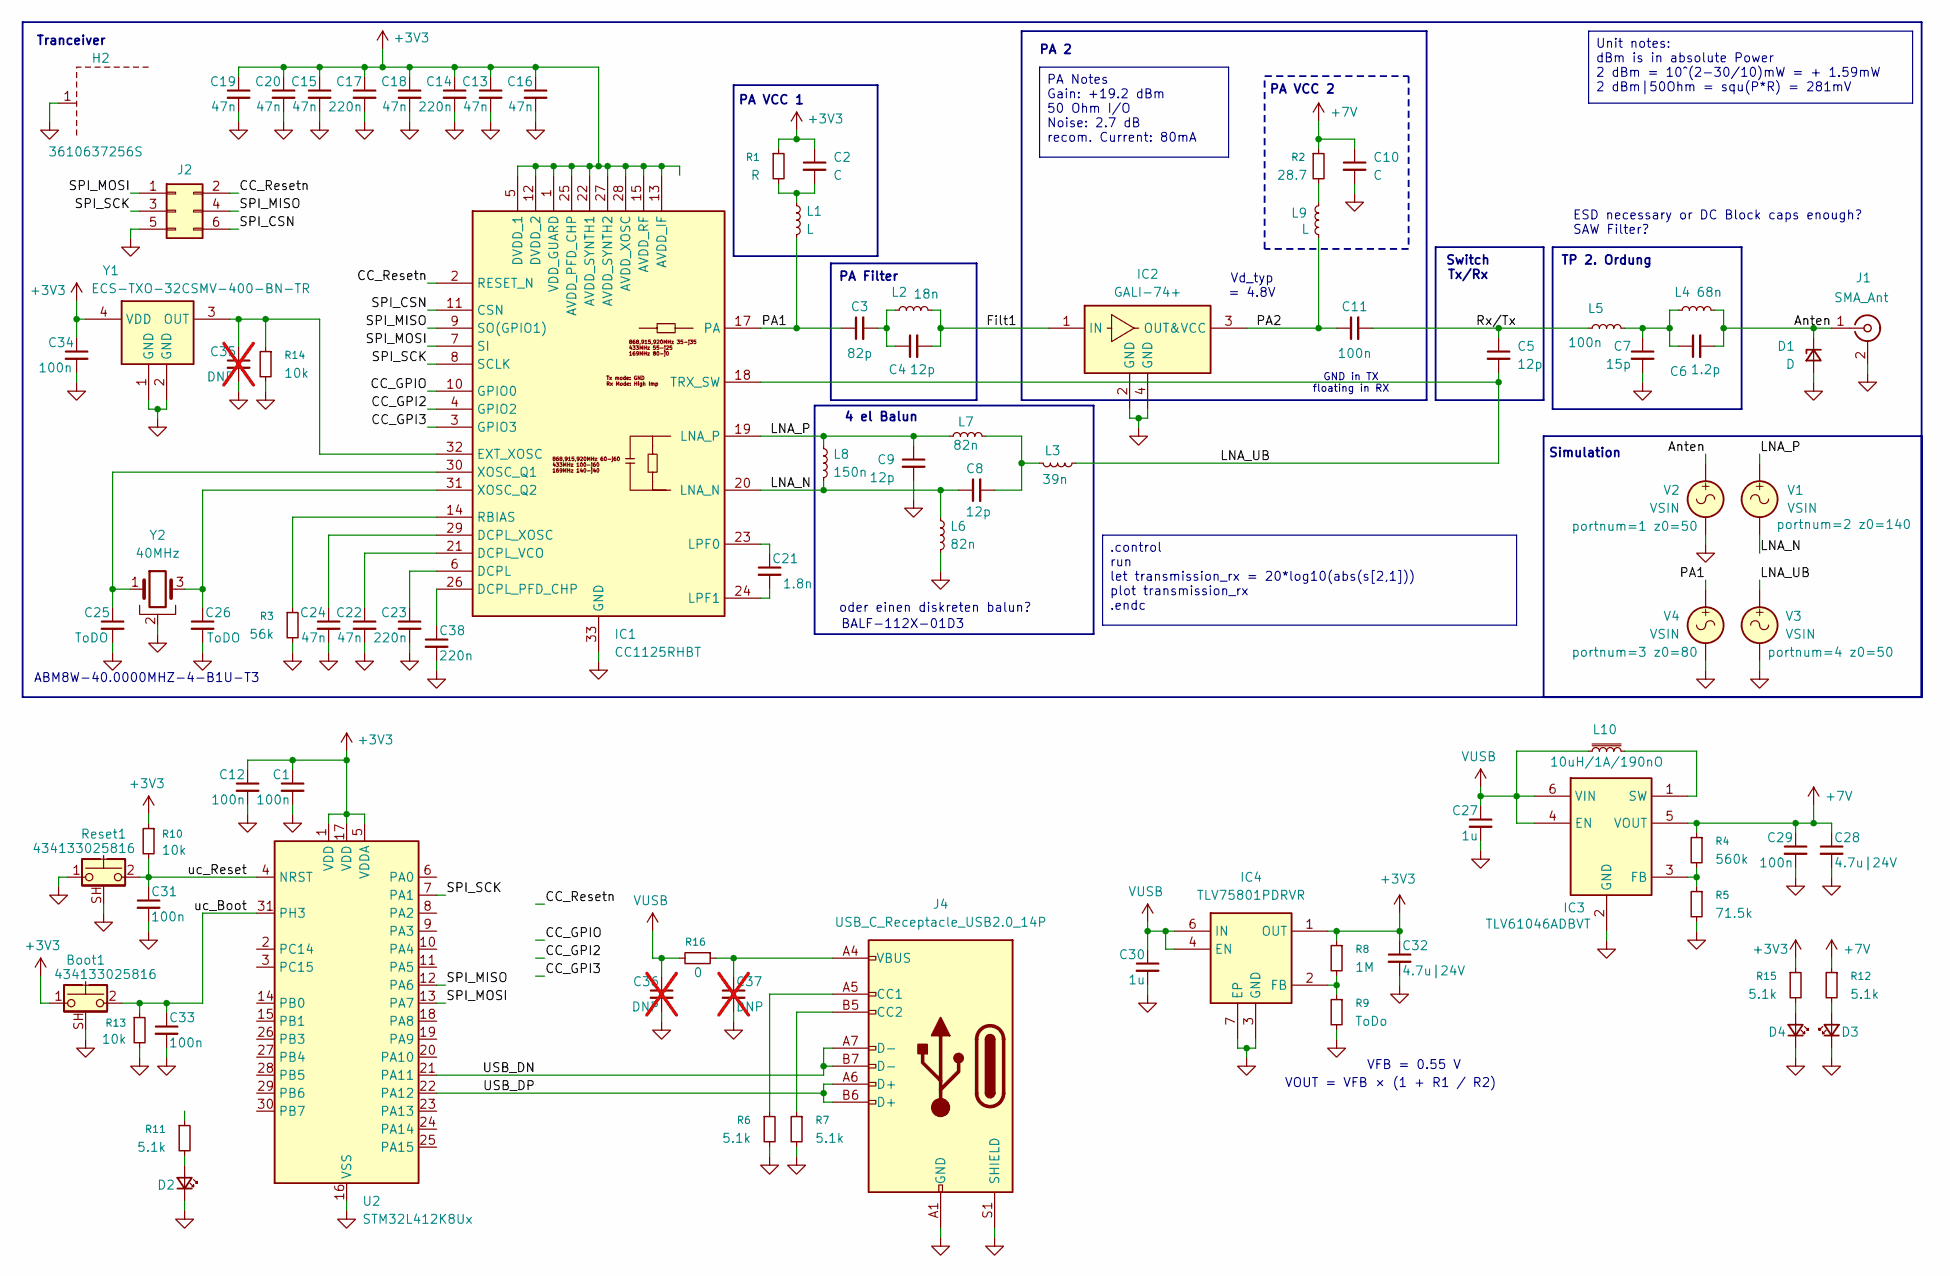
[picture p43: schematic CC1125_Transceiver.kicad_sch]

Parts:
Boot1: 434133025816
C1, C11, C12, C29, C31, C33, C34: 100n; C_0402_1005Metric_Pad0.74x0.62mm_HandSolder
C2, C10: C; C_0402_1005Metric_Pad0.74x0.62mm_HandSolder
C3: 82p; C_0402_1005Metric_Pad0.74x0.62mm_HandSolder
C4, C5, C8, C9: 12p; C_0402_1005Metric_Pad0.74x0.62mm_HandSolder
C6: 1.2p; C_0402_1005Metric_Pad0.74x0.62mm_HandSolder
C7: 15p; C_0402_1005Metric_Pad0.74x0.62mm_HandSolder
C13, C15, C16, C18, C19, C20, C22, C24: 47n; C_0402_1005Metric_Pad0.74x0.62mm_HandSolder
C14, C17, C23, C38: 220n; C_0402_1005Metric_Pad0.74x0.62mm_HandSolder
C21: 1.8n; C_0402_1005Metric_Pad0.74x0.62mm_HandSolder
C25, C26: ToDO; C_0402_1005Metric_Pad0.74x0.62mm_HandSolder
C27, C30: 1u; C_0402_1005Metric_Pad0.74x0.62mm_HandSolder
C28, C32: 4.7u|24V; C_0805_2012Metric_Pad1.18x1.45mm_HandSolder
C35: DNP; C_0402_1005Metric_Pad0.74x0.62mm_HandSolder; not fitted
C36, C37: DNP; C_0805_2012Metric_Pad1.18x1.45mm_HandSolder; not fitted
D1: D
D2, D3, D4: LED_0402_1005Metric_Pad0.77x0.64mm_HandSolder
H2: 3610637256S; H_Wurth_WE-SHC-SMT-FRAME_3610637256S; Part Number 3670288
IC1: CC1125RHBT; QFN50P500X500X100-33N-D; Mouser Part Number 595-CC1125RHBT
IC2: GALI-74+; GVA63; Mouser Part Number 139-GALI-74
IC3: TLV61046ADBVT; SOT95P280X145-6N; Mouser Part Number 595-TLV61046ADBVT
IC4: TLV75801PDRVR; SON65P200X200X80-7N; Mouser Part Number 595-TLV75801PDRVR
J1: SMA_Ant; SMA_Amphenol_132289_EdgeMount
J2: Conn_02x03_Counter_Clockwise; PinHeader_2x03_P1.00mm_Vertical_SMD
J4: USB_C_Receptacle_USB2.0_14P; USB421603A
L1, L9: L; L_0402_1005Metric_Pad0.77x0.64mm_HandSolder
L2: 18n; L_0402_1005Metric_Pad0.77x0.64mm_HandSolder
L3: 39n; L_0402_1005Metric_Pad0.77x0.64mm_HandSolder
L4: 68n; L_0402_1005Metric_Pad0.77x0.64mm_HandSolder
L5: 100n; L_0402_1005Metric_Pad0.77x0.64mm_HandSolder
L6, L7: 82n; L_0402_1005Metric_Pad0.77x0.64mm_HandSolder
L8: 150n; L_0402_1005Metric_Pad0.77x0.64mm_HandSolder
L10: 10uH/1A/190nO; WE-TPC_282892
R1: R; R_0402_1005Metric_Pad0.72x0.64mm_HandSolder
R2: 28.7; R_0402_1005Metric_Pad0.72x0.64mm_HandSolder
R3: 56k; R_0603_1608Metric_Pad0.98x0.95mm_HandSolder
R4: 560k; R_0402_1005Metric_Pad0.72x0.64mm_HandSolder
R5: 71.5k; R_0402_1005Metric_Pad0.72x0.64mm_HandSolder
R6, R7, R11, R12, R15: 5.1k; R_0402_1005Metric_Pad0.72x0.64mm_HandSolder
R8: 1M; R_0402_1005Metric_Pad0.72x0.64mm_HandSolder
R9: ToDo; R_0402_1005Metric_Pad0.72x0.64mm_HandSolder
R10, R13, R14: 10k; R_0603_1608Metric_Pad0.98x0.95mm_HandSolder
R16: 0; R_0603_1608Metric_Pad0.98x0.95mm_HandSolder
Reset1: 434133025816
U2: STM32L412K8Ux; QFN-32-1EP_5x5mm_P0.5mm_EP3.45x3.45mm
V1, V2, V3, V4: VSIN
Y1: ECS-TXO-32CSMV-400-BN-TR; ECSTXO32CSMV400BNTR; Mouser Part Number 520-TXO32CSMV400BNTR
Y2: 40MHz; ABM8W480000MHZ6D1XT3

Connections:
+3V3: Boot1.1, C1.1, C2.1, C12.1, C13.1, C14.1, C15.1, C16.1, C17.1, C18.1, C19.1, C20.1, C32.1, C34.1, C38.1, IC1.1 (VDD_GUARD), IC1.5 (DVDD_1), IC1.12 (DVDD_2), IC1.13 (AVDD_IF), IC1.15 (AVDD_RF), IC1.22 (AVDD_SYNTH1), IC1.25 (AVDD_PFD_CHP), IC1.26 (DCPL_PFD_CHP), IC1.27 (AVDD_SYNTH2), IC1.28 (AVDD_XOSC), IC4.1 (OUT), R1.1, R8.1, R10.1, R15.1, U2.1 (VDD), U2.5 (VDDA), U2.17 (VDD), Y1.4 (VDD)
+7V: C10.1, C28.1, C29.1, IC3.5 (VOUT), R2.1, R4.1, R12.1
/Anten: C6.2, D1.1 (K), J1.1 (In), L4.2, V2.1
/CC_GPI2: IC1.4 (GPIO2)
/CC_GPI3: IC1.3 (GPIO3)
/CC_GPIO: IC1.10 (GPIO0)
/CC_Resetn: IC1.2 (RESET_N), J2.2
/Filt1: C4.2, IC2.1 (IN), L2.2
/Filt2: C5.1, C11.2, L5.1
/LNA_N: C8.1, IC1.20 (LNA_N), L6.1, L8.2, V1.2
/LNA_P: C9.1, IC1.19 (LNA_P), L7.1, L8.1, V1.1
/LNA_UB: C5.2, IC1.18 (TRX_SW), L3.2, V3.1
/PA1: C3.1, IC1.17 (PA), L1.2, V4.1
/PA2: C11.1, IC2.3 (OUT&VCC), L9.2
/SPI_CSN: IC1.11 (CSN), J2.6
/SPI_MISO: IC1.9 (SO(GPIO1)), J2.4, U2.12 (PA6)
/SPI_MOSI: IC1.7 (SI), J2.1, U2.13 (PA7)
/SPI_SCK: IC1.8 (SCLK), J2.3, U2.7 (PA1)
/USB_DN: J4.A7 (D-), J4.B7 (D-), U2.21 (PA11)
/USB_DP: J4.A6 (D+), J4.B6 (D+), U2.22 (PA12)
/uc_Boot: Boot1.2, C33.1, R13.1, U2.31 (PH3)
/uc_Reset: C31.1, R10.2, Reset1.2, U2.4 (NRST)
GND: Boot1.SH (B), C1.2, C7.2, C9.2, C10.2, C12.2, C13.2, C14.2, C15.2, C16.2, C17.2, C18.2, C19.2, C20.2, C22.2, C23.2, C24.2, C25.2, C26.2, C27.2, C28.2, C29.2, C30.2, C31.2, C32.2, C33.2, C34.2, C35.2, C36.2, C37.2, C38.2, D1.2 (A), D2.1 (K), D3.1 (K), D4.1 (K), H2.1 (GND), IC1.33 (GND), IC2.2 (GND), IC2.4 (GND), IC3.2 (GND), IC4.3 (GND), IC4.7 (EP), J1.2 (Ext), J2.5, J4.A1 (GND), J4.A12 (GND), J4.B1 (GND), J4.B12 (GND), J4.S1 (SHIELD), L6.2, R3.2, R5.2, R6.2, R7.2, R9.2, R13.2, R14.2, Reset1.1, Reset1.SH (B), U2.16 (VSS), U2.32 (VSS), U2.33 (VSS), V2.2, V3.2, V4.2, Y1.1 (GND), Y1.2 (GND), Y2.2
unnamed: C2.2, L1.1, R1.2
unnamed: C3.2, C4.1, L2.1
unnamed: C6.1, C7.1, L4.1, L5.2
unnamed: C8.2, L3.1, L7.2
unnamed: C37.1, J4.A4 (VBUS), J4.A9 (VBUS), J4.B4 (VBUS), J4.B9 (VBUS), R16.1
unnamed: D2.2 (A), R11.2
unnamed: D3.2 (A), R12.2
unnamed: D4.2 (A), R15.2
unnamed: C23.1, IC1.6 (DCPL)
unnamed: C22.1, IC1.21 (DCPL_VCO)
unnamed: C24.1, IC1.29 (DCPL_XOSC)
unnamed: C35.1, IC1.32 (EXT_XOSC), R14.1, Y1.3 (OUT)
unnamed: C21.1, IC1.23 (LPF0)
unnamed: C21.2, IC1.24 (LPF1)
unnamed: IC1.14 (RBIAS), R3.1
unnamed: C25.1, IC1.30 (XOSC_Q1), Y2.1
unnamed: C26.1, IC1.31 (XOSC_Q2), Y2.3
unnamed: IC3.3 (FB), R4.2, R5.1
unnamed: IC3.1 (SW), L10.2
unnamed: IC4.2 (FB), R8.2, R9.1
unnamed: J4.A5 (CC1), R6.1
unnamed: J4.B5 (CC2), R7.1
unnamed: L9.1, R2.2
VUSB: C27.1, C30.1, C36.1, IC3.4 (EN), IC3.6 (VIN), IC4.4 (EN), IC4.6 (IN), L10.1, R16.2

Notes on the sheet:
PA 2
Tranceiver
Simulation
4 el Balun
PA VCC 2
Vd_typ = 4.8V
Switch Tx/Rx
TP 2. Ordung
BALF-112X-01D3
VFB = 0.55 V
ABM8W-40.0000MHZ-4-B1U-T3
GND in TX floating in RX
oder einen diskreten balun?
ESD necessary or DC Block caps enough? SAW Filter?
PA VCC 1
VOUT = VFB × (1 + R1 / R2)
PA Filter
Unit notes: dBm is in absolute Power 2 dBm = 10^(2-30/10)mW = + 1.59mW 2 dBm|50Ohm = squ(P*R) = 281mV
.control run let transmission_rx = 20*log10(abs(s[2,1])) plot transmission_rx .endc
PA Notes Gain: +19.2 dBm 50 Ohm I/O Noise: 2.7 dB recom. Current: 80mA

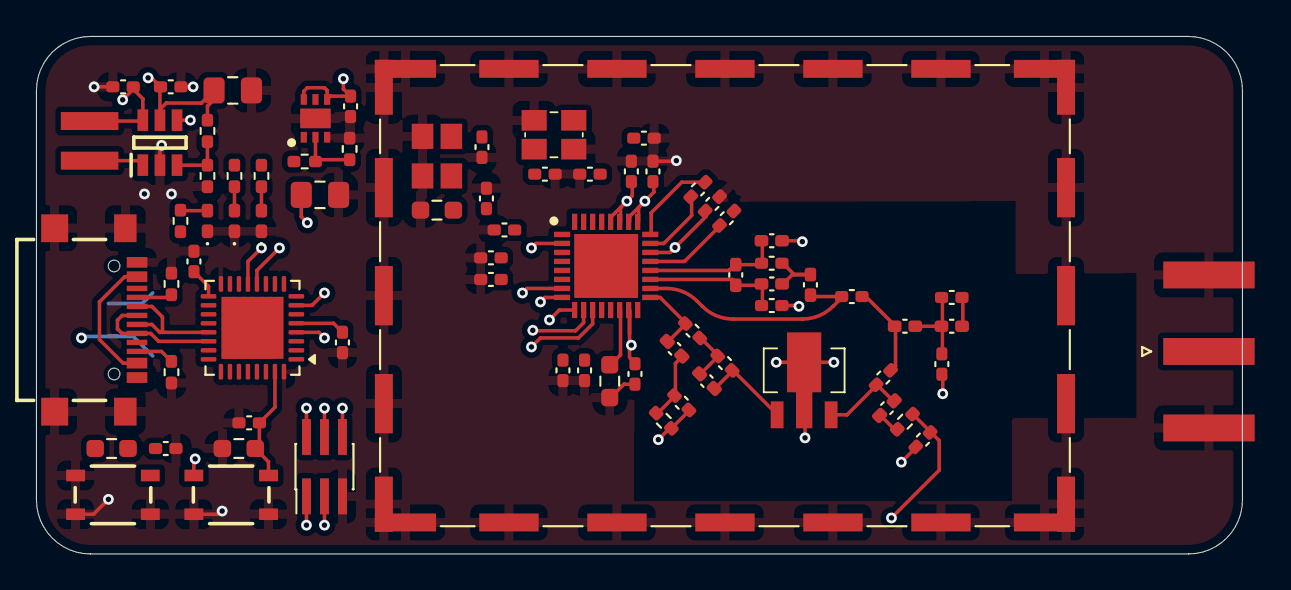
[picture p44: board CC1125_Transceiver.kicad_pcb from above]

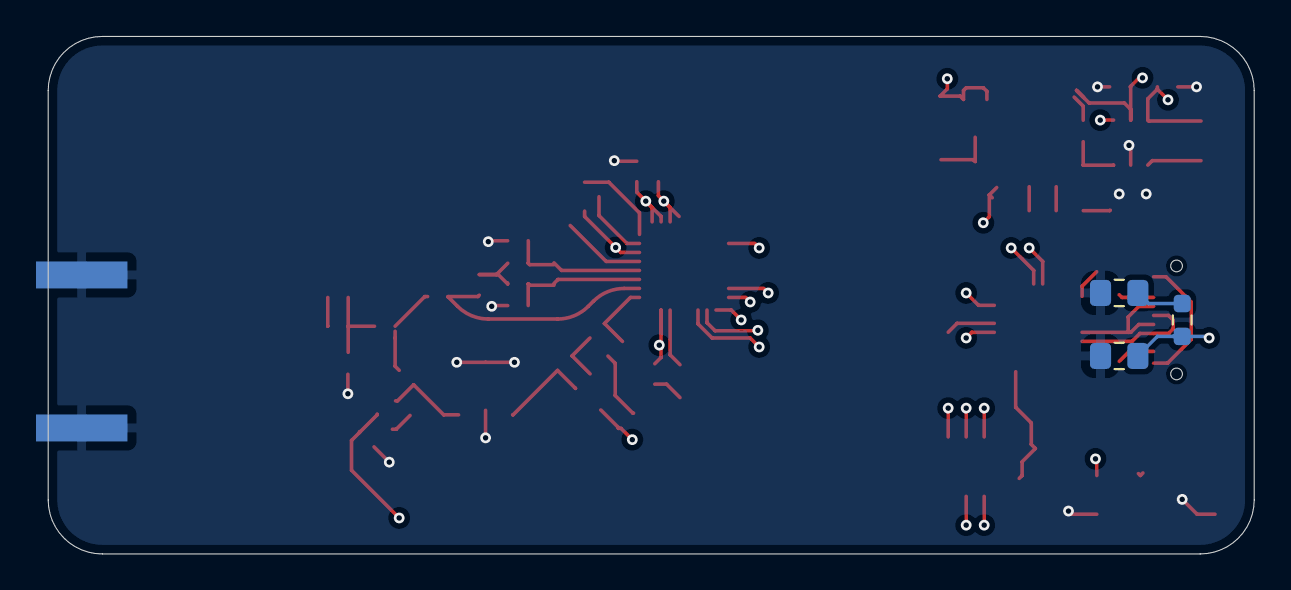
[picture p45: board CC1125_Transceiver.kicad_pcb from below]

Board: 4 copper layers, 67.0 x 28.8 mm, 79 parts (3 on the bottom side), 44 nets.
