Flynsky/VHF_Transceiver/software/software.ioc

Mcu.UserName=STM32L412K8Ux
PA1.Signal=SPI1_SCK
PA11.Signal=USB_DM
PA12.Signal=USB_DP
PA6.Signal=SPI1_MISO
PA7.Signal=SPI1_MOSI
